keeratrajsinghwork/Stack_based_FC_tMIT/PDB/PDB_Board2.png

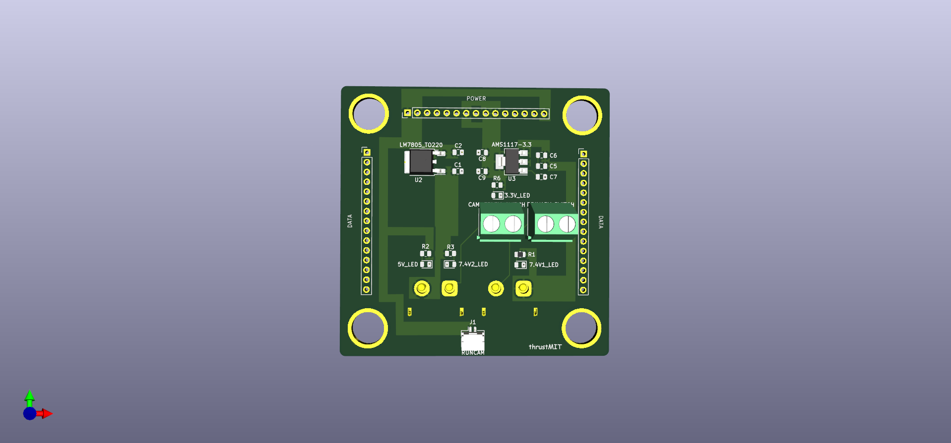
PDB/PDB_Board2.png
