keeratrajsinghwork/Stack_based_FC_tMIT/PDB/PDB_Board.png

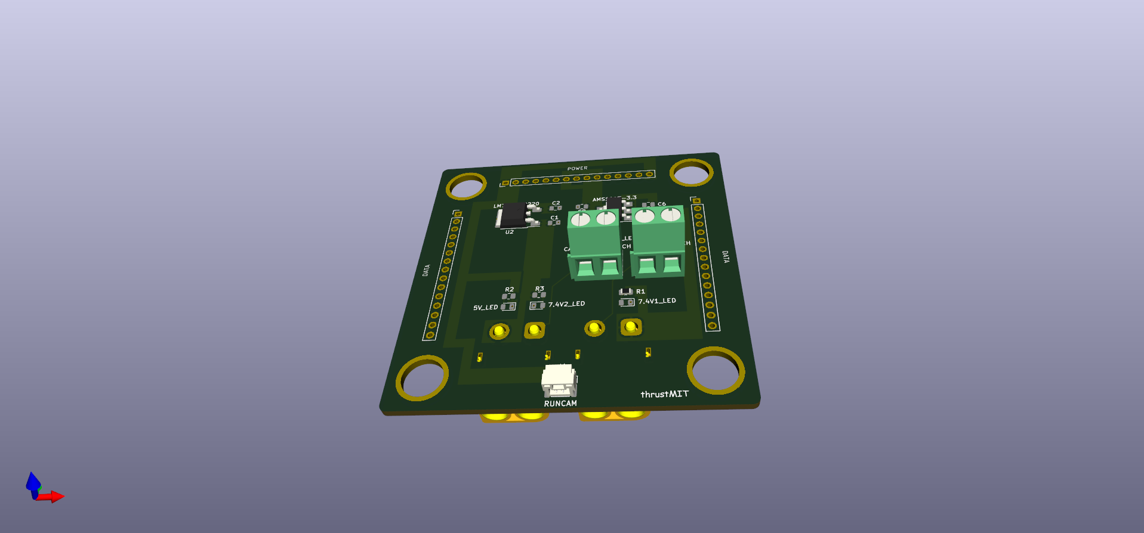
PDB/PDB_Board.png
