keeratrajsinghwork/Stack_based_FC_tMIT/PDB/PDB_Board1.png

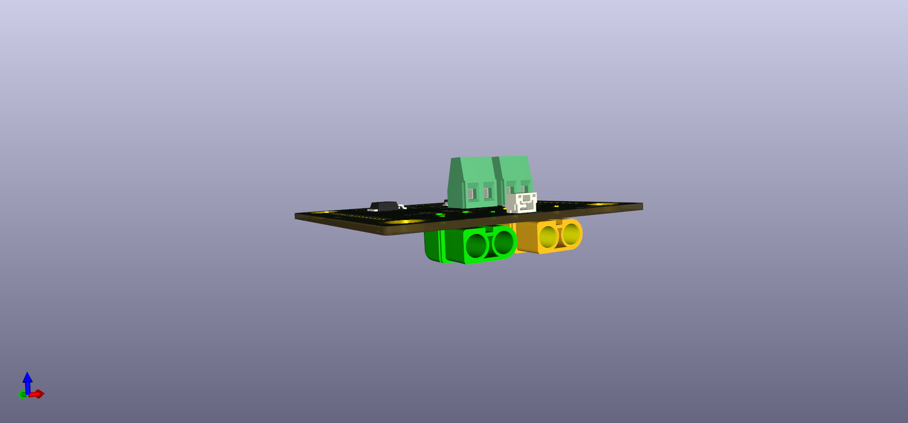
PDB/PDB_Board1.png
