keeratrajsinghwork/Stack_based_FC_tMIT/BOM_Agniastra.xlsx

Sheet: Master_BOM
Sl No. | Component Name | Description | Price(per unit) | Qty | Total Price | Link to Product | Information | Vendor
1 | PZT2222A | Transistor | 33.25 | 10 | 332.5 | PZT2222AT3G - Onsemi - Bipolar (BJT) Single Transistor, NPN, 40 V (element14.com) (https://in.element14.com/on-semiconductor/pzt2222at3g/transistor-bipol-npn-40v-sot-223/dp/2533342?st=pzt2222a) |  | Element14
2 | Capacitor(0805) | 0.1uF | 18 | 7 | 126 | MC0805B104K101CT MULTICOMP PRO MLCC SMD Capacitor 0.1µF, 100 V, 0805 ( Pack of 5) - Robu.in | Indian Online Store | RC Hobby | Robotics (https://robu.in/product/mc0805b104k101ct-multicomp-pro-cap-smd-mlcc-0-1%c2%b5f-100-v-0805-pack-of-5/) | (Pack of 5) | Robu
3 | Capacitor(0805) | 10uF | 12.65 | 2 | 25.3 | TMCP1A106MTRF - Vishay - Surface Mount Tantalum Capacitor, 10 µF, 10 V (element14.com) (https://in.element14.com/vishay/tmcp1a106mtrf/cap-10uf-10v-tant-case-p/dp/3369499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) | (Pack of 5) | Element14
4 | Capacitor(0805) | 0.1uF Tantalum | 21.2 | 2 | 42.4 | TMCP1D104KTRF - Vishay - Surface Mount Tantalum Capacitor, 0.1 µF, 20 V (element14.com) (https://in.element14.com/vishay/tmcp1d104ktrf/cap-0-1-f-20v-10/dp/2491439?st=capacitor%20smd%200.1uf) | (Pack of 5) | Element14
5 | Capacitor(0805) | 4.7uF | 18.9 | 10 | 189 | C0805C475M3PACTU - Kemet - SMD Multilayer Ceramic Capacitor, 4.7 µF, 25 V (element14.com) (https://in.element14.com/kemet/c0805c475m3pactu/cap-4-7-f-25v-20-x5r-0805/dp/2773271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) | minimum order = 10 | Element14
6 | Capacitor(0805) | 10pF | 7.99 | 10 | 79.9 | C0805C100J3GACTU - Kemet - SMD Multilayer Ceramic Capacitor, 10 pF, 25 V (element14.com) (https://in.element14.com/kemet/c0805c100j3gactu/cap-10pf-25v-5-c0g-np0-0805/dp/2905171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) | minimum order = 10 | Element14
7 | Capacitor(0806) | 1uF | 10.98 | 10 | 109.8 | C0805C105K3RECTU - Kemet - SMD Multilayer Ceramic Capacitor, ESD, 1 µF (element14.com) (https://in.element14.com/kemet/c0805c105k3rectu/cap-1uf-25v-mlcc-0805/dp/2991344?st=capacitor%200805%201uF) | minimum order = 10 | Element14
8 | Capacitor(0805) | 0.33uF | 35 | 1 | 35 | Buy 330nF 0805 Surface Mount Multilayer Ceramic Capacitor Online (robu.in) (https://robu.in/product/330nf-0805-surface-mount-multilayer-ceramic-capacitor-pack-of-40/) | (Pack of 40) | Robu
9 | Resistor(0805) | 22 ohm | 0.349 | 30 | 10.47 | MCWR08X22R0FTL - Multicomp Pro - SMD Chip Resistor, 22 ohm, ± 1% (element14.com) (https://in.element14.com/multicomp/mcwr08x22r0ftl/res-22r-1-0-125w-0805-thick-film/dp/2447609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) | minimum order = 10 | Element14
10 | Resistor(0805) | 56 ohm | 1.83 | 30 | 54.9 | WR08X560 JTL - Walsin - SMD Chip Resistor, 56 ohm, ± 5% (element14.com) (https://in.element14.com/walsin/wr08x560-jtl/res-56r-5-0-125w-0805-thick-film/dp/2671059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) | minimum order = 10 | Element14
11 | Resistor(0805) | 100 ohm | 25 | 1 | 25 | Buy 100 Ohm 1/4W 0805 Surface Mount Chip Resistor Online | Robu.in (https://robu.in/product/100-ohm-1-4w-0805-surface-mount-chip-resistor-10-pcs/) | Pack of 10 | Robu
12 | Resistor(0805) | 10k ohm | 29 | 1 | 29 | Buy 10k Ohm 1/4W 0805 Surface Mount Chip Resistor Online | Robu.in (https://robu.in/product/10k-ohm-1-4w-0805-surface-mount-chip-resistor-pack-of-10/) | Pack of 10 | Robu
13 | Resistor(0805) | 2.5k | 11.07 | 10 | 110.7 | MCWF08U2551BTL - Multicomp Pro - SMD Chip Resistor, 2.55 kohm, ± 0.1% (element14.com) (https://in.element14.com/multicomp-pro/mcwf08u2551btl/res-thin-film-2k55-0-1-0-1w-0805/dp/2694274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) | minimum order = 10 | Element14
14 | Resistor(0805) | 200k | 1.21 | 10 | 12.1 | MCSR08X2003FTL - Multicomp Pro - SMD Chip Resistor, 200 kohm, ± 1% (element14.com) (https://in.element14.com/multicomp-pro/mcsr08x2003ftl/res-200k-1-0-125w-0805-thick-film/dp/2074396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) | Pack of 10 | Element14
15 | Resistor(0805) | 383 ohm | 8.31 | 5 | 41.55 | RC0805FR-07383RL - Yageo - RES, 383R, 1% (element14.com) (https://in.element14.com/yageo/rc0805fr-07383rl/res-383r-1-0-125w-thick-film-0805/dp/4061076) |  | Element14
16 | Resistor(0805) | 220 ohm | 4.82 | 10 | 48.2 | ERJUP6J221V - Panasonic - SMD Chip Resistor, 220 ohm, ± 5% (element14.com) (https://in.element14.com/panasonic/erjup6j221v/res-220r-5-0-5w-0805-thick-film/dp/3598292) | minimum order = 10 | Element14
17 | LEDs(0805) | Red | 9.28 | 15 | 139.2 | MP008293 - Multicomp Pro - LED, Red, SMD (element14.com) (https://in.element14.com/multicomp-pro/mp008293/led-red-220mcd-626nm-0805/dp/3796325?st=led%200805) | minimum order = 5 | Element14
18 | LEDs(0805) | Green | 33.15 | 15 | 497.25 | KPT-2012ZGC - Kingbright - LED, Low Power, Green (element14.com) (https://in.element14.com/kingbright/kpt-2012zgc/led-smd-0805-true-green/dp/2217981?st=led%200805%203.3v) | minimum order = 5 | Element14
19 | LEDs(0805) | Blue | 12.77 | 10 | 127.7 | KP-2012QBC-D - Kingbright - LED, Low Power, Blue (element14.com) (https://in.element14.com/kingbright/kp-2012qbc-d/led-smd-0805-blue/dp/2217974?st=led%200805%203.3v) | minimum order = 5 | Element14
20 | LM7805 | Voltage Regulator | 112.05 | 5 | 560.25 | LM78M05CDTX/NOPB - Texas Instruments - Linear Voltage Regulator, Fixed, 7.2V to 35V Input (element14.com) (https://in.element14.com/texas-instruments/lm78m05cdtx-nopb/ldo-fixed-5v-0-5a-to-252-3/dp/3008066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) |  | Element14
21 | AMS1117 | Voltage Regulator | 45 | 1 | 45 | Buy AMS1117-3.3V 1A SOT-223 Voltage Regulator IC (Pack of 5 ICs) Online at Robu.in (https://robu.in/product/ams1117-3-3v-1a-sot-223-voltage-regulator-ic-pack-of-5-ics/) | (Pack of 5) | Robu
22 | Pin Headers | 1x40 | 157 | 2 | 314 | Buy 2.54mm 1x40 Pin Male Single Row Straight Long Header Strip (3 pcs.) (robu.in) (https://robu.in/product/2-54mm-1x40-pin-male-single-row-straight-long-header-strip-pack-of-3/) | (Pack of 3) | Robu
23 | Terminal Block | Terminals | 12 | 5 | 60 | Buy Degson 2 Pin 5.08mm PCB Terminal Block Online at Robu.in (https://robu.in/product/degson-2-pin-5-08mm-pcb-terminal-block/) |  | Robu
24 | microSD card | Connector | 152.99 | 2 | 305.98 | 104031-0811 - Molex - Memory Card Connector, MicroSD, Push-Pull (element14.com) (https://in.element14.com/molex/104031-0811/connector-micro-sd-8pos/dp/2678573?st=104031-0811) |  | Element14
25 | Terminal Block | Terminals 1x03 | 18 | 3 | 54 | 3 Pin Screw Terminal - 2 Pieces pack buy online at Low Price in India - ElectronicsComp.com (https://www.electronicscomp.com/3-pin-screw-terminal?search=3%20pin%205.08mm%20terminal) | (Pack of 2) | Electronics comp
26 | Crystal | Oscillator | 44.17 | 2 | 88.34 | ABM8G-27.000MHZ-18-D2Y-T. - Abracon - CRYSTAL, 27MHZ, 18PF (element14.com) (https://in.element14.com/abracon/abm8g-27-000mhz-18-d2y-t/crystal-27mhz-18pf-3-2-x-2-5mm/dp/1788527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) |  | Element14
27 | D4184 | MOSFET | 52 | 5 | 260 | Buy D4184 Mosfet control Module Replacement Relay Online at Robu.in (https://robu.in/product/d4184-mosfet-control-module-replacement-relay/) |  | Robu
28 | XT60 | Connector(Horizontal) | 199 | 5 | 995 | Probots XT60PW-F Female Connector for LiPo Battery ESC Brushless Motor Buy Online India (https://probots.co.in/xt150-m-male-black-connector-for-lipo-battery-esc-brushless-motor-6.html) |  | Probots
29 | JST | Connector | 38.2 | 4 | 152.8 | SM02B-GHS-TB JST Sales America Inc. | Connectors, Interconnects | DigiKey (https://www.digikey.in/en/products/detail/jst-sales-america-inc./SM02B-GHS-TB/807832?productid=807832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) |  | Digi-Key
30 | Switch PB | Switch | 63.91 | 1 | 63.91 | https://www.mouser.in/ProductDetail/Alps-Alpine/SKRKAEE020?qs=MrosSN5%252BUQW89XjXIp8Ugw%3D%3D&mgh=1
 |  | TOTAL |  |  | 4871.34
 | NOTE: The colours don't mean anything, it is just to sort and look through easily.

Sheet: Sensor
Sl No. | Component Name | Description | Price(per unit) | Qty | Total Price | Link to Product | Information | Vendor
1 | PZT2222A |  | 33.25 | 5 | 166.25 | PZT2222AT3G - Onsemi - Bipolar (BJT) Single Transistor, NPN, 40 V (element14.com) (https://in.element14.com/on-semiconductor/pzt2222at3g/transistor-bipol-npn-40v-sot-223/dp/2533342?st=pzt2222a) |  | Element14
2 | Capacitor(0805) | 0.1uF | 18 | 2 | 36 | MC0805B104K101CT MULTICOMP PRO MLCC SMD Capacitor 0.1µF, 100 V, 0805 ( Pack of 5) - Robu.in | Indian Online Store | RC Hobby | Robotics (https://robu.in/product/mc0805b104k101ct-multicomp-pro-cap-smd-mlcc-0-1%c2%b5f-100-v-0805-pack-of-5/) | (Pack of 5) | Robu
3 | Capacitor(0805) | 10uF | 12.65 | 1 | 12.65 | TMCP1A106MTRF - Vishay - Surface Mount Tantalum Capacitor, 10 µF, 10 V (element14.com) (https://in.element14.com/vishay/tmcp1a106mtrf/cap-10uf-10v-tant-case-p/dp/3369499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) | (Pack of 5) | Element14
4 | Capacitor(0805) | 0.1uF Tantalum | 21.2 | 2 | 42.4 | TMCP1D104KTRF - Vishay - Surface Mount Tantalum Capacitor, 0.1 µF, 20 V (element14.com) (https://in.element14.com/vishay/tmcp1d104ktrf/cap-0-1-f-20v-10/dp/2491439?st=capacitor%20smd%200.1uf) | (Pack of 5) | Element14
5 | Resistor(0805) | 22 ohm | 0.349 | 10 | 3.49 | MCWR08X22R0FTL - Multicomp Pro - SMD Chip Resistor, 22 ohm, ± 1% (element14.com) (https://in.element14.com/multicomp/mcwr08x22r0ftl/res-22r-1-0-125w-0805-thick-film/dp/2447609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) |  | Element14
6 | Resistor(0805) | 56 ohm | 1.83 | 10 | 18.3 | WR08X560 JTL - Walsin - SMD Chip Resistor, 56 ohm, ± 5% (element14.com) (https://in.element14.com/walsin/wr08x560-jtl/res-56r-5-0-125w-0805-thick-film/dp/2671059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) |  | Element14
7 | Resistor(0805) | 100 ohm | 25 | 1 | 25 | Buy 100 Ohm 1/4W 0805 Surface Mount Chip Resistor Online | Robu.in (https://robu.in/product/100-ohm-1-4w-0805-surface-mount-chip-resistor-10-pcs/) | Pack of 10 | Robu
8 | LEDs | Red | 9.28 | 5 | 46.4 | MP008293 - Multicomp Pro - LED, Red, SMD (element14.com) (https://in.element14.com/multicomp-pro/mp008293/led-red-220mcd-626nm-0805/dp/3796325?st=led%200805) | minimum order = 5 | Element14
9 | LEDs | Green | 33.15 | 5 | 165.75 | KPT-2012ZGC - Kingbright - LED, Low Power, Green (element14.com) (https://in.element14.com/kingbright/kpt-2012zgc/led-smd-0805-true-green/dp/2217981?st=led%200805%203.3v) | minimum order = 5 | Element14
10 | LEDs | Blue | 12.77 | 5 | 63.85 | KP-2012QBC-D - Kingbright - LED, Low Power, Blue (element14.com) (https://in.element14.com/kingbright/kp-2012qbc-d/led-smd-0805-blue/dp/2217974?st=led%200805%203.3v) | minimum order = 5 | Element14
 |  | TOTAL |  |  | 580.09

Sheet: MC
Sl No. | Component Name | Description | Price(per unit) | Qty | Total Price | Link to Product | Information | Vendor
1 | PZT2222A |  | 33.25 | 5 | 166.25 | PZT2222AT3G - Onsemi - Bipolar (BJT) Single Transistor, NPN, 40 V (element14.com) (https://in.element14.com/on-semiconductor/pzt2222at3g/transistor-bipol-npn-40v-sot-223/dp/2533342?st=pzt2222a) |  | Element14
2 | Capacitor(0805) | 0.1uF | 18 | 3 | 54 | MC0805B104K101CT MULTICOMP PRO MLCC SMD Capacitor 0.1µF, 100 V, 0805 ( Pack of 5) - Robu.in | Indian Online Store | RC Hobby | Robotics (https://robu.in/product/mc0805b104k101ct-multicomp-pro-cap-smd-mlcc-0-1%c2%b5f-100-v-0805-pack-of-5/) | (Pack of 5) | Robu
3 | Capacitor(0805) | 1uF | 10.98 | 10 | 109.8 | C0805C105K3RECTU - Kemet - SMD Multilayer Ceramic Capacitor, ESD, 1 µF (element14.com) (https://in.element14.com/kemet/c0805c105k3rectu/cap-1uf-25v-mlcc-0805/dp/2991344?st=capacitor%200805%201uF) | minimum order = 10 | Element14
4 | Capacitor(0805) | 4.7uF | 18.9 | 10 | 189 | C0805C475M3PACTU - Kemet - SMD Multilayer Ceramic Capacitor, 4.7 µF, 25 V (element14.com) (https://in.element14.com/kemet/c0805c475m3pactu/cap-4-7-f-25v-20-x5r-0805/dp/2773271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) | minimum order = 10 | Element14
5 | Capacitor(0805) | 10pF | 7.99 | 10 | 79.9 | C0805C100J3GACTU - Kemet - SMD Multilayer Ceramic Capacitor, 10 pF, 25 V (element14.com) (https://in.element14.com/kemet/c0805c100j3gactu/cap-10pf-25v-5-c0g-np0-0805/dp/2905171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) | minimum order = 10 | Element14
6 | Resistor(0805) | 22 ohm | 0.349 | 20 | 6.98 | MCWR08X22R0FTL - Multicomp Pro - SMD Chip Resistor, 22 ohm, ± 1% (element14.com) (https://in.element14.com/multicomp/mcwr08x22r0ftl/res-22r-1-0-125w-0805-thick-film/dp/2447609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) |  | Element14
7 | Resistor(0805) | 56 ohm | 1.83 | 10 | 18.3 | WR08X560 JTL - Walsin - SMD Chip Resistor, 56 ohm, ± 5% (element14.com) (https://in.element14.com/walsin/wr08x560-jtl/res-56r-5-0-125w-0805-thick-film/dp/2671059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) |  | Element14
8 | Resistor(0805) | 10k ohm | 29 | 1 | 29 | Buy 10k Ohm 1/4W 0805 Surface Mount Chip Resistor Online | Robu.in (https://robu.in/product/10k-ohm-1-4w-0805-surface-mount-chip-resistor-pack-of-10/) | Pack of 10 | Robu
9 | Resistor(0805) | 2.5k | 11.07 | 10 | 110.7 | MCWF08U2551BTL - Multicomp Pro - SMD Chip Resistor, 2.55 kohm, ± 0.1% (element14.com) (https://in.element14.com/multicomp-pro/mcwf08u2551btl/res-thin-film-2k55-0-1-0-1w-0805/dp/2694274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) | minimum order = 10 | Element14
10 | Resistor(0805) | 200k | 1.21 | 10 | 12.1 | MCSR08X2003FTL - Multicomp Pro - SMD Chip Resistor, 200 kohm, ± 1% (element14.com) (https://in.element14.com/multicomp-pro/mcsr08x2003ftl/res-200k-1-0-125w-0805-thick-film/dp/2074396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) | Pack of 10 | Element14
11 | Resistor(0805) | 383 ohm | 8.31 | 5 | 41.55 | RC0805FR-07383RL - Yageo - RES, 383R, 1% (element14.com) (https://in.element14.com/yageo/rc0805fr-07383rl/res-383r-1-0-125w-thick-film-0805/dp/4061076) |  | Element14
12 | LEDs | Red | 9.28 | 5 | 46.4 | MP008293 - Multicomp Pro - LED, Red, SMD (element14.com) (https://in.element14.com/multicomp-pro/mp008293/led-red-220mcd-626nm-0805/dp/3796325?st=led%200805) | minimum order = 5 | Element14
13 | LEDs | Green | 33.15 | 5 | 165.75 | KPT-2012ZGC - Kingbright - LED, Low Power, Green (element14.com) (https://in.element14.com/kingbright/kpt-2012zgc/led-smd-0805-true-green/dp/2217981?st=led%200805%203.3v) | (Pack of 5) | Element14
14 | LEDs | Blue | 12.77 | 5 | 63.85 | KP-2012QBC-D - Kingbright - LED, Low Power, Blue (element14.com) (https://in.element14.com/kingbright/kp-2012qbc-d/led-smd-0805-blue/dp/2217974?st=led%200805%203.3v) | minimum order = 5 | Element14
15 | Pin Headers | 1x40 | 157 | 1 | 157 | Buy 2.54mm 1x40 Pin Male Single Row Straight Long Header Strip (3 pcs.) (robu.in) (https://robu.in/product/2-54mm-1x40-pin-male-single-row-straight-long-header-strip-pack-of-3/) | (Pack of 3) | Robu
16 | microSD card | Connector | 152.99 | 2 | 305.98 | 104031-0811 - Molex - Memory Card Connector, MicroSD, Push-Pull (element14.com) (https://in.element14.com/molex/104031-0811/connector-micro-sd-8pos/dp/2678573?st=104031-0811) |  | Element14
17 | Crystal | Oscillator | 44.17 | 2 | 88.34 | ABM8G-27.000MHZ-18-D2Y-T. - Abracon - CRYSTAL, 27MHZ, 18PF (element14.com) (https://in.element14.com/abracon/abm8g-27-000mhz-18-d2y-t/crystal-27mhz-18pf-3-2-x-2-5mm/dp/1788527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) |  | Element14
18 | Switch PB | Switch |  |  | 0
 |  | TOTAL |  |  | 1644.9

Sheet: PDB
Sl No. | Component Name | Description | Price(per unit) | Qty | Total Price | Link to Product | Information | Vendor
1 | LM7805 | Voltage Regulator | 112.05 | 5 | 560.25 | LM78M05CDTX/NOPB - Texas Instruments - Linear Voltage Regulator, Fixed, 7.2V to 35V Input (element14.com) (https://in.element14.com/texas-instruments/lm78m05cdtx-nopb/ldo-fixed-5v-0-5a-to-252-3/dp/3008066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) |  | Element14
2 | AMS1117 | Voltage Regulator | 45 | 1 | 45 | Buy AMS1117-3.3V 1A SOT-223 Voltage Regulator IC (Pack of 5 ICs) Online at Robu.in (https://robu.in/product/ams1117-3-3v-1a-sot-223-voltage-regulator-ic-pack-of-5-ics/) | (Pack of 5) | Robu
3 | Capacitor(0805) | 0.1uF | 18 | 2 | 36 | MC0805B104K101CT MULTICOMP PRO MLCC SMD Capacitor 0.1µF, 100 V, 0805 ( Pack of 5) - Robu.in | Indian Online Store | RC Hobby | Robotics (https://robu.in/product/mc0805b104k101ct-multicomp-pro-cap-smd-mlcc-0-1%c2%b5f-100-v-0805-pack-of-5/) | (Pack of 5) | Robu
4 | Capacitor(0805) | 0.33uF | 35 | 1 | 35 | Buy 330nF 0805 Surface Mount Multilayer Ceramic Capacitor Online (robu.in) (https://robu.in/product/330nf-0805-surface-mount-multilayer-ceramic-capacitor-pack-of-40/) | (Pack of 40) | Robu
5 | Capacitor(0805) | 10uF | 12.65 | 1 | 12.65 | TMCP1A106MTRF - Vishay - Surface Mount Tantalum Capacitor, 10 µF, 10 V (element14.com) (https://in.element14.com/vishay/tmcp1a106mtrf/cap-10uf-10v-tant-case-p/dp/3369499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) | (Pack of 5) | Element14
6 | Resistor(0805) | 220 ohm | 4.82 | 10 | 48.2 | ERJUP6J221V - Panasonic - SMD Chip Resistor, 220 ohm, ± 5% (element14.com) (https://in.element14.com/panasonic/erjup6j221v/res-220r-5-0-5w-0805-thick-film/dp/3598292) | minimum order = 10 | Element14
7 | Resistor(0805) | 56 ohm | 1.83 | 10 | 18.3 | WR08X560 JTL - Walsin - SMD Chip Resistor, 56 ohm, ± 5% (element14.com) (https://in.element14.com/walsin/wr08x560-jtl/res-56r-5-0-125w-0805-thick-film/dp/2671059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) |  | Element14
8 | LEDs | Red | 9.28 | 5 | 46.4 | MP008293 - Multicomp Pro - LED, Red, SMD (element14.com) (https://in.element14.com/multicomp-pro/mp008293/led-red-220mcd-626nm-0805/dp/3796325?st=led%200805) | minimum order = 5 | Element14
9 | LEDs | Green | 33.15 | 5 | 165.75 | KPT-2012ZGC - Kingbright - LED, Low Power, Green (element14.com) (https://in.element14.com/kingbright/kpt-2012zgc/led-smd-0805-true-green/dp/2217981?st=led%200805%203.3v) | minimum order = 5 | Element14
10 | Pin Headers | 1x40 | 157 | 1 | 157 | Buy 2.54mm 1x40 Pin Male Single Row Straight Long Header Strip (3 pcs.) (robu.in) (https://robu.in/product/2-54mm-1x40-pin-male-single-row-straight-long-header-strip-pack-of-3/) | (Pack of 3) | Robu
11 | JST | Connector | 38.2 | 4 | 152.8 | SM02B-GHS-TB JST Sales America Inc. | Connectors, Interconnects | DigiKey (https://www.digikey.in/en/products/detail/jst-sales-america-inc./SM02B-GHS-TB/807832?productid=807832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) |  | Digi-Key
12 | Terminal Block | Terminals | 12 | 5 | 60 | Buy Degson 2 Pin 5.08mm PCB Terminal Block Online at Robu.in (https://robu.in/product/degson-2-pin-5-08mm-pcb-terminal-block/) |  | Robu
13 | XT60 | Connector(Horizontal) | 199 | 5 | 995 | Probots XT60PW-F Female Connector for LiPo Battery ESC Brushless Motor Buy Online India (https://probots.co.in/xt150-m-male-black-connector-for-lipo-battery-esc-brushless-motor-6.html) |  | Probots
 |  | TOTAL |  |  | 2332.35

Sheet: GPIO
Sl No. | Component Name | Description | Price(per unit) | Qty | Total Price | Link to Product | Information | Vendor
1 | Terminal Block | Terminals 1x03 | 18 | 3 | 54 | 3 Pin Screw Terminal - 2 Pieces pack buy online at Low Price in India - ElectronicsComp.com (https://www.electronicscomp.com/3-pin-screw-terminal?search=3%20pin%205.08mm%20terminal) | (Pack of 2) | Electronics comp
2 | D4184 | MOSFET | 52 | 5 | 260 | Buy D4184 Mosfet control Module Replacement Relay Online at Robu.in (https://robu.in/product/d4184-mosfet-control-module-replacement-relay/) |  | Robu
 |  | TOTAL |  |  | 314
