keeratrajsinghwork/Stack_based_FC_tMIT/BOM_Infyuva_ver4.xlsx

Part Number | Quantity | Description | Price | Link
 | 10 | JST connector | 90 | https://robu.in/product/3-pin-jst-xh-2-54mm-pitch-plug-and-socket-with-cable-10-pcs
RCD-24-0.35 | 2 | LED Driver RCD-24-0.35 | 1729.38 | https://in.element14.com/recom-power/rcd-24-0-35/led-driver-dc-dc-cc-0-35a-35v/dp/1793212?ICID=I-RP-STM7REC-2
 | 3 | 10K Potentiometer | 79 | https://robu.in/product/10k-ohm-3pin-15mm-shaft-potentiometer-pack-of-3/
 | 5 | Terminal block | 10 | https://robu.in/product/2-pin-5-08mm-pitch-pluggable-screw-terminal-block-pack-of-3/
 | 1 | Battery | 701.96 | https://quartzcomponents.com/products/12v-2200-mah-rechargeable-lithium-battery-pack-with-warranty-for-gps-cctv-industrial-and-commercial-application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
 |  | Hookup wires | 149 | https://robu.in/product/high-quality-ultra-flexible-24awg-silicone-wire-5m-red/
C0603C103K2RECTU | 10 | Capacitors 10n | 43.8 | https://in.element14.com/multicomp/mcsh31b103k500ct/cap-0-01-f-50v-10-x7r-1206/dp/1856592
SRR1208-121YL | 2 | Inductor 120uH | 146.52 | https://in.element14.com/bourns/srr1208-121yl/inductor-120uh-15-1-4a-smd/dp/2333691
MCWF08R2611BTL | 10 | Resistors 2.61k | 128.7 | https://in.element14.com/panasonic/erj8enf2611v/res-2k61-1-0-25w-1206-thick-film/dp/2307566
ERJP06F4641V | 10 | Resistors 4.64k | 80.7 | https://in.element14.com/panasonic/erjp08f4641v/res-4k64-1-0-66w-1206-thick-film/dp/2327245
 |  | Total | 3159.06
