keeratrajsinghwork/Stack_based_FC_tMIT/FC'24.xlsx

Sheet: Main
S.no | Name | Description | Quantity | Price/piece | Cost | Vendor | Link | Stock | Status | Voltage Rating(V) | Current Consumption(A) | Units | Operation Duration (h) | FOS
1 | STM32411CEU SMT | MC | 1 | 675 | 675 | Digikey | https://www.digikey.in/en/products/detail/stmicroelectronics/STM32F411CEU6/4935720 | 13000 |  | 3.3 | 100 | μ
2 | LPS22HB THT | Baro low G | 1 | 578 | 578 | Digikey | https://www.digikey.in/en/products/detail/adafruit-industries-llc/4633/12396897?productid=12396897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 | 31 |  |  |  | μ | 5 | 1.2
3 | LPS22HB SMT |  | 1 | 370 | 370 | Element14 | https://in.element14.com/stmicroelectronics/lps22hbtr/pressure-sensor-26-126kpa-40to85deg/dp/2532382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 | 93000 |  | 3.3 | 12 | μ
4 | MS6507 THT | Baro high G | 1 | 2028 | 2028 | Tanotis | https://www.tanotis.com/products/mikroelektronika-mikroe-3030-add-on-board-altitude-2-click-ms5607-barometric-pressure-sensor-i2c-spi-mikrobus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 | . |  |  |  | μ | Battery | Capacity (mAh) | Voltage (V) | Max Discharge (C) | Dimensions(mm) | Weight (g) | Cost | Vendor | Link | Stock | Status
5 | MS6507 SMT |  | 1 | 903 | 903 | Digikey | https://www.digikey.in/en/products/detail/te-connectivity-measurement-specialties/MS560702BA03-50/4700931 | 61000 |  | 3.3 | 12.5 | μ | SRAD | 1000 | 7.4 | 5 | 70 x 40 x 25 | 130 | 589 | Robu | https://robu.in/product/orange-isr-18650-li-ion-1500mah-7-4v-2s1p-protected-battery-pack-15c/ | OnDemand
6 | LSM6DS032X THT | IMU low G | 1 | 2301 | 2301 | Tanotis | https://www.tanotis.com/products/stmicroelectronics-steval-mki221v1-plug-in-module-lsm6dso32x-mems-motherboard-new | . |  |  |  | μ | COTS | 600 | 7.4 | 5 | 70 x 40 x 24 | 130 | 589 | Robu | https://robu.in/product/orange-isr-18650-li-ion-1500mah-7-4v-2s1p-protected-battery-pack-15c/?gad_source=1 | OnDemand
7 | LSM6DS032X SMT |  | 1 | 613 | 613 | Element14 | https://in.element14.com/stmicroelectronics/lsm6dso32xtr/mems-module-1-71v-to-3-6v-lga/dp/3758574?st=lsm6dso | 10500 |  | 3.3 | 170 | μ | Pyro | 2000 | 7.4 | 10 | 80 x 30 x 50 | 141 | 1159 | Robu | https://robu.in/product/panasonic-ncr18650ga-7-4v-3300mah-3c-2s1p-li-ion-battery-pack/ | OnDemand
8 | ADXL375 THT | IMU high G | 1 | 2082 | 2082 | Adafruit | https://www.adafruit.com/product/5374 | 27 |  |  |  | μ | Camera + Telem | 6000 | 7.4 | 3 | 73 x 44 x 44 | 150 | 1539 | Robu | https://robu.in/product/orange-18650-li-ion-6000mah-7-4v-2s1p-protected-battery-pack-3c/ | OnDemand
9 | ADXL375 SMT |  | 1 | 1270 | 1270 | Element14 | https://in.element14.com/analog-devices/adxl375bccz-rl7/mems-accelerometer-digital-x-y/dp/4030128?st=adxl37 | 2100 |  | 3.3 | 35 | μ
10 | Mikroe GNSS 8 Click | GPS | 1 | 4574 | 4574 | Digikey | https://www.digikey.in/en/products/detail/mikroelektronika/MIKROE-4673/16182517 | 6 |  | 3.3 | 36 | μ | Component | Weight (g) |  | Key
11 | RYLR998 | Telem 1 | 2 | 3398 | x | Amazon | https://www.amazon.in/RYLR998-Interface-Antenna-Transceiver-Module/dp/B099RM1XMG | . |  | 3.3 | 140 | m | SRAD Stack | 1350 |  |  | Not Ordered
12 | LAMBDA-9S | Telem 2 | 2 | 1929 | x | Element14 | https://in.element14.com/rf-solutions/lambda-9s/rf-transceiver-module-300kbps/dp/2841160 | 1900 |  | 3.3 | 125 | m | COTS | 50 |  |  | PO Placed
13 | Runcam Thumb | Camera | 2 | 5499 | 10998 | Robu | https://robu.in/product/runcam-thumb-1080p-mini-action-camera/ | . |  | 5 | 280 | m | Cameras | 20 |  |  | Ordered
14 |  | TX antenna |  |  | 0 |  |  |  |  |  |  |  | Batteries | 551 |  |  | Received
15 |  | RX antenna |  |  | 0 |  |  |  |  |  |  |  | Rods | 624 |  |  | Refunded
16 | RFD900ux US | Telem XX | 1 | 25511 | 25511 | RFDesign | https://store.rfdesign.com.au/rfd900x-us-modem-bundle-fcc-approved-hs-8517-62-00-90/ | . |  | 5 | 1 |  | Mounts | 300
17 | Pin Headers Tall | Stack connectors | 10 | 89 | 890 | ElectronicsComp | https://www.electronicscomp.com/1x40-pin-2.54mm-pitch-straight-long-female-berg-strip-connector?gad_source=1 | 232
18 |  |  |  |  | 0
19 |  |  |  |  | 0
20 |  |  |  |  | 0
21 |  |  |  |  | 0
22 |  |  |  |  | 0
23 |  |  |  |  | 0 |  |  |  |  |  |  |  | Total | 2895
24 |  |  |  |  | 0
25 |  |  |  |  | 0
26 |  |  |  |  | 0
27 |  |  |  |  | 0
28 |  |  |  |  | 0
29 |  |  |  |  | 0
30 |  |  |  |  | 0
 |  |  |  | Total | 56080

Sheet: Indian
S.no | Name | Description | Quantity | Price/piece | Cost | Vendor | Link | Stock | Status
1 | STM32411CEU SMT | MC | 1 | 617 | 617 | Arrow | https://www.arrow.com/en/products/stm32f411ceu6/stmicroelectronics?gad_source=1&gclsrc=aw.ds | 964
2 | LPS22HB THT | Baro low G | 1 | 576 | 576 | Mouser | https://www.mouser.in/ProductDetail/Adafruit/4633?qs=W%2FMpXkg%252BdQ4ebNdNVsYA5Q%3D%3D | 74
3 | LPS22HB SMT |  | 1 | 294 | 294 | Arrow | https://www.arrow.com/en/products/lps22hbtr/stmicroelectronics | 4200
4 | MS6507 THT | Baro high G | 1 | 2028 | 2028 | Tanotis | https://www.tanotis.com/products/mikroelektronika-mikroe-3030-add-on-board-altitude-2-click-ms5607-barometric-pressure-sensor-i2c-spi-mikrobus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 | .
5 | MS6507 SMT |  | 1 | 831 | 831 | Mouser | https://www.mouser.in/ProductDetail/Measurement-Specialties/MS560702BA03-50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 | 54400
6 | LSM6DS032X THT | IMU low G | 1 | 2301 | 2301 | Tanotis | https://www.tanotis.com/products/stmicroelectronics-steval-mki221v1-plug-in-module-lsm6dso32x-mems-motherboard-new | .
7 | LSM6DS032X SMT |  | 1 | 613 | 613 | Element14 | https://in.element14.com/stmicroelectronics/lsm6dso32xtr/mems-module-1-71v-to-3-6v-lga/dp/3758574?st=lsm6dso | 10500
8 | ADXL375 THT | IMU high G | 1 | 3286 | 3286 | Element14 | https://in.element14.com/analog-devices/eval-adxl375z/eval-board-3-axis-mems-accelerometer/dp/4033199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 | 2
9 | ADXL375 SMT |  | 1 | 1270 | 1270 | Element14 | https://in.element14.com/analog-devices/adxl375bccz-rl7/mems-accelerometer-digital-x-y/dp/4030128?st=adxl37 | 2100
10 | Mikroe GNSS 8 Click | GPS | 1 |  | 1 |  |  | .
11 | RYLR998 | Telem 1 | 2 |  | 2 |  |  | .
12 | LAMBDA-9S | Telem 2 | 2 |  | 2 |  |  | .
13 | Runcam Thumb | Camera | 2 |  | 2 |  |  | .
14 |  | TX antenna |  |  | 0 |  |  | .
15 |  | RX antenna |  |  | 0 |  |  | .
16 | RFD900ux US | Telem XX | 1 |  | 1 |  |  | .
17 | Pin Headers Tall | Stack connectors | 10 |  | 10 |  |  | .
18 |  |  |  |  | 0 |  |  | .
19 |  |  |  |  | 0 |  |  | .
20 |  |  |  |  | 0 |  |  | ..
21 |  |  |  |  | 0 |  |  | .
22 |  |  |  |  | 0
23 |  |  |  |  | 0
24 |  |  |  |  | 0 |  |  | .
25 |  |  |  |  | 0 |  |  | .
26 |  |  |  |  | 0
27 |  |  |  |  | 0 |  |  | .
28 |  |  |  |  | 0
29 |  |  |  |  | 0 |  |  | .
30 |  |  |  |  | 0 |  |  | .
 |  |  |  | Total | 11834

Sheet: Sheet2
S.no | Name | Description | Quantity | Price/piece | Cost | Vendor | Link | Stock | Status
1 | STM32411CEU SMT | MC | 1 | 675 | 675 | Digikey | https://www.digikey.in/en/products/detail/stmicroelectronics/STM32F411CEU6/4935720 | 13000
2 | LPS22HB THT | Baro low G | 1 | 578 | 578 | Digikey | https://www.digikey.in/en/products/detail/adafruit-industries-llc/4633/12396897?productid=12396897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 | 31
3 | LPS22HB SMT |  | 1 | 370 | 370 | Element14 | https://in.element14.com/stmicroelectronics/lps22hbtr/pressure-sensor-26-126kpa-40to85deg/dp/2532382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 | 93000
4 | MS6507 THT | Baro high G | 1 | 2028 | 2028 | Tanotis | https://www.tanotis.com/products/mikroelektronika-mikroe-3030-add-on-board-altitude-2-click-ms5607-barometric-pressure-sensor-i2c-spi-mikrobus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 | .
5 | MS6507 SMT |  | 1 | 903 | 903 | Digikey | https://www.digikey.in/en/products/detail/te-connectivity-measurement-specialties/MS560702BA03-50/4700931 | 61000
6 | LSM6DS032X THT | IMU low G | 1 | 2301 | 2301 | Tanotis | https://www.tanotis.com/products/stmicroelectronics-steval-mki221v1-plug-in-module-lsm6dso32x-mems-motherboard-new | .
7 | LSM6DS032X SMT |  | 1 | 613 | 613 | Element14 | https://in.element14.com/stmicroelectronics/lsm6dso32xtr/mems-module-1-71v-to-3-6v-lga/dp/3758574?st=lsm6dso | 10500
8 | ADXL375 THT | IMU high G | 1 | 2082 | 2082 | Adafruit | https://www.adafruit.com/product/5374 | 27
9 | ADXL375 SMT |  | 1 | 1270 | 1270 | Element14 | https://in.element14.com/analog-devices/adxl375bccz-rl7/mems-accelerometer-digital-x-y/dp/4030128?st=adxl37 | 2100
10 | Mikroe GNSS 8 Click | GPS | 1 | 4574 | 4574 | Digikey | https://www.digikey.in/en/products/detail/mikroelektronika/MIKROE-4673/16182517 | 6
11 | RYLR998 | Telem 1 | 2 | 3398 | x | Amazon | https://www.amazon.in/RYLR998-Interface-Antenna-Transceiver-Module/dp/B099RM1XMG | .
12 | LAMBDA-9S | Telem 2 | 2 | 1929 | x | Element14 | https://in.element14.com/rf-solutions/lambda-9s/rf-transceiver-module-300kbps/dp/2841160 | 1900
13 | Runcam Thumb | Camera | 2 | 5499 | 10998 | Robu | https://robu.in/product/runcam-thumb-1080p-mini-action-camera/ | .
14 |  | TX antenna |  |  | 0
15 |  | RX antenna |  |  | 0
16 | RFD900ux US | Telem XX | 1 | 25511 | 25511 | RFDesign | https://store.rfdesign.com.au/rfd900x-us-modem-bundle-fcc-approved-hs-8517-62-00-90/ | .
17 | Pin Headers Tall | Stack connectors | 10 | 89 | 890 | ElectronicsComp | https://www.electronicscomp.com/1x40-pin-2.54mm-pitch-straight-long-female-berg-strip-connector?gad_source=1 | 232
18 |  |  |  |  | 0
19 |  |  |  |  | 0
20 |  |  |  |  | 0
21 |  |  |  |  | 0
22 |  |  |  |  | 0
23 |  |  |  |  | 0
24 |  |  |  |  | 0
25 |  |  |  |  | 0
26 |  |  |  |  | 0
27 |  |  |  |  | 0
28 |  |  |  |  | 0
29 |  |  |  |  | 0
30 |  |  |  |  | 0
 |  |  |  | Total | 52793
