keeratrajsinghwork/Stack_based_FC_tMIT/MC_stack/MC_stack.step

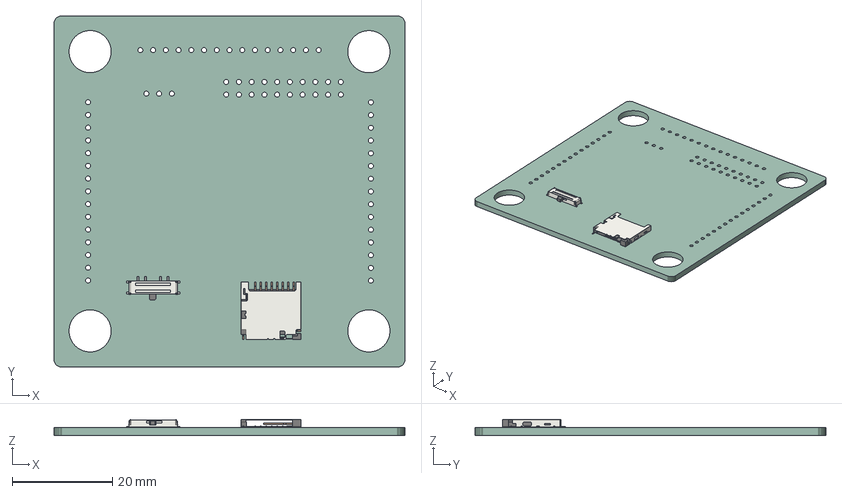
[picture p4: CAD file, 2024-08-11]
MC_stack/MC_stack.step
70.0 x 70.0 x 3.20 mm
MC_stack PCB
