keeratrajsinghwork/Stack_based_FC_tMIT/PDB/PDB_Board.step

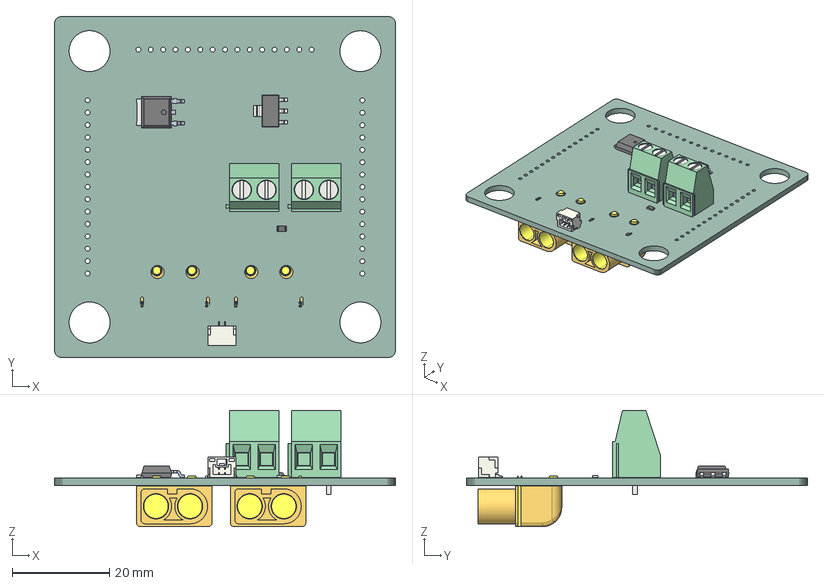
[picture p5: CAD file, 2024-08-11]
PDB/PDB_Board.step
70.0 x 70.0 x 23.9 mm
PDB_Board PCB
