keeratrajsinghwork/Stack_based_FC_tMIT/Sensor_stack/Sensor_Stack/Sensor_Stack.step

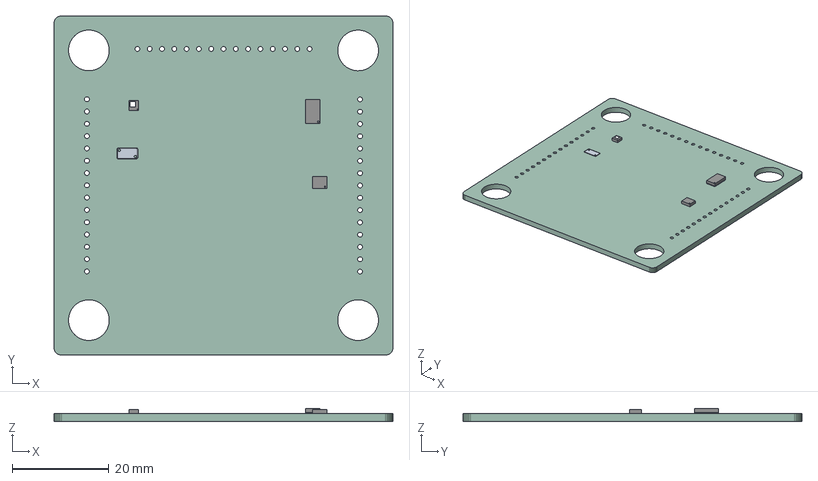
[picture p6: CAD file, 2024-08-11]
Sensor_stack/Sensor_Stack/Sensor_Stack.step
70.0 x 70.0 x 2.63 mm
Sensor_Stack PCB
