keeratrajsinghwork/Stack_based_FC_tMIT/Telemetry_stack/Telemetry_Stack/Telemetry_Stack.step

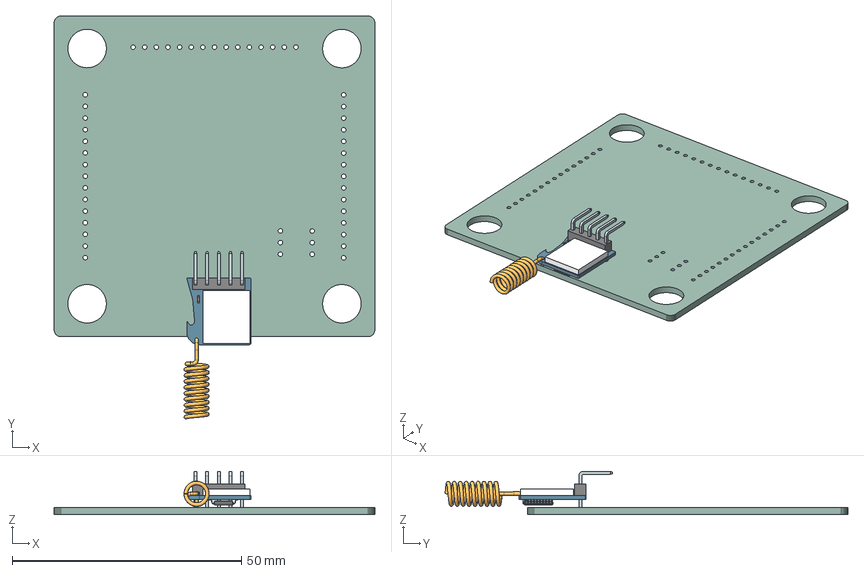
[picture p7: CAD file, 2024-08-11]
Telemetry_stack/Telemetry_Stack/Telemetry_Stack.step
70.0 x 88.0 x 9.42 mm
_autosave-Telemetry_Stack PCB
