keeratrajsinghwork/Stack_based_FC_tMIT/Blank diagram (1).pdf

Wi | r i | ng Di | agr am f or FC' 24

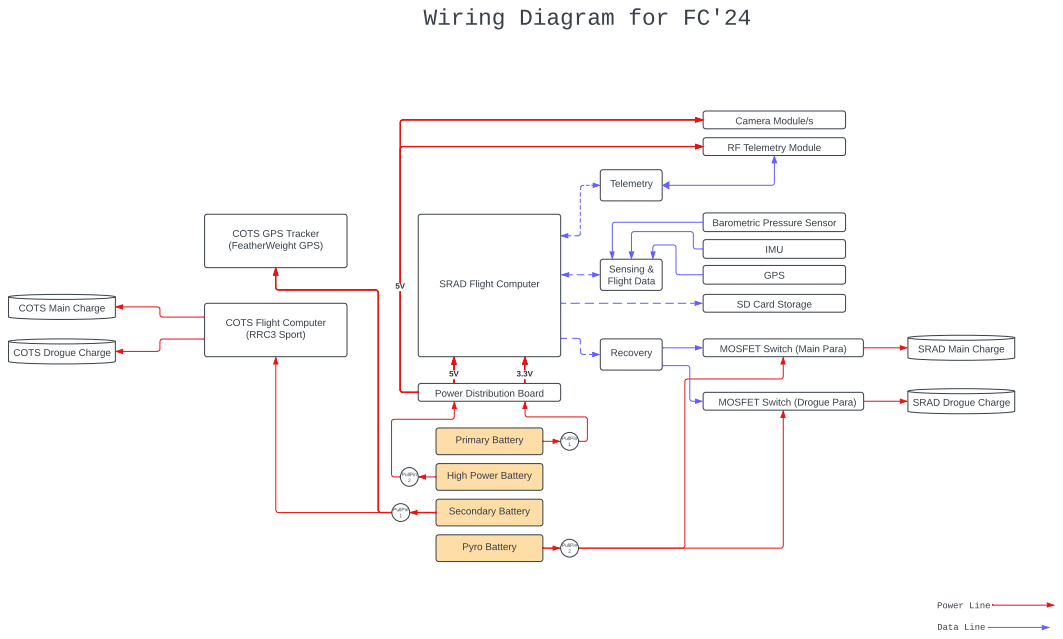
[picture p8: page 1]
Primary Battery; Secondary Battery; Pyro Battery; IMU; GPS; Sensing & Flight Data; Recovery; MOSFET Switch (Main Para); Camera Module/s; Telemetry; PullPin 1; PullPin 2

RF Telemetry Module

Barometric Pressure Sensor

COTS GPS Tracker
(FeatherWeight GPS)

SRAD Flight Computer

SD Card Storage

COTS Main Charge

COTS Flight Computer
(RRC3 Sport)

COTS Drogue Charge

SRAD Main Charge

Power Distribution Board

MOSFET Switch (Drogue Para)

SRAD Drogue Charge

High Power Battery

Power Li ne

Dat a Li ne
