keeratrajsinghwork/Stack_based_FC_tMIT/GPIO_stack/gpio.pdf

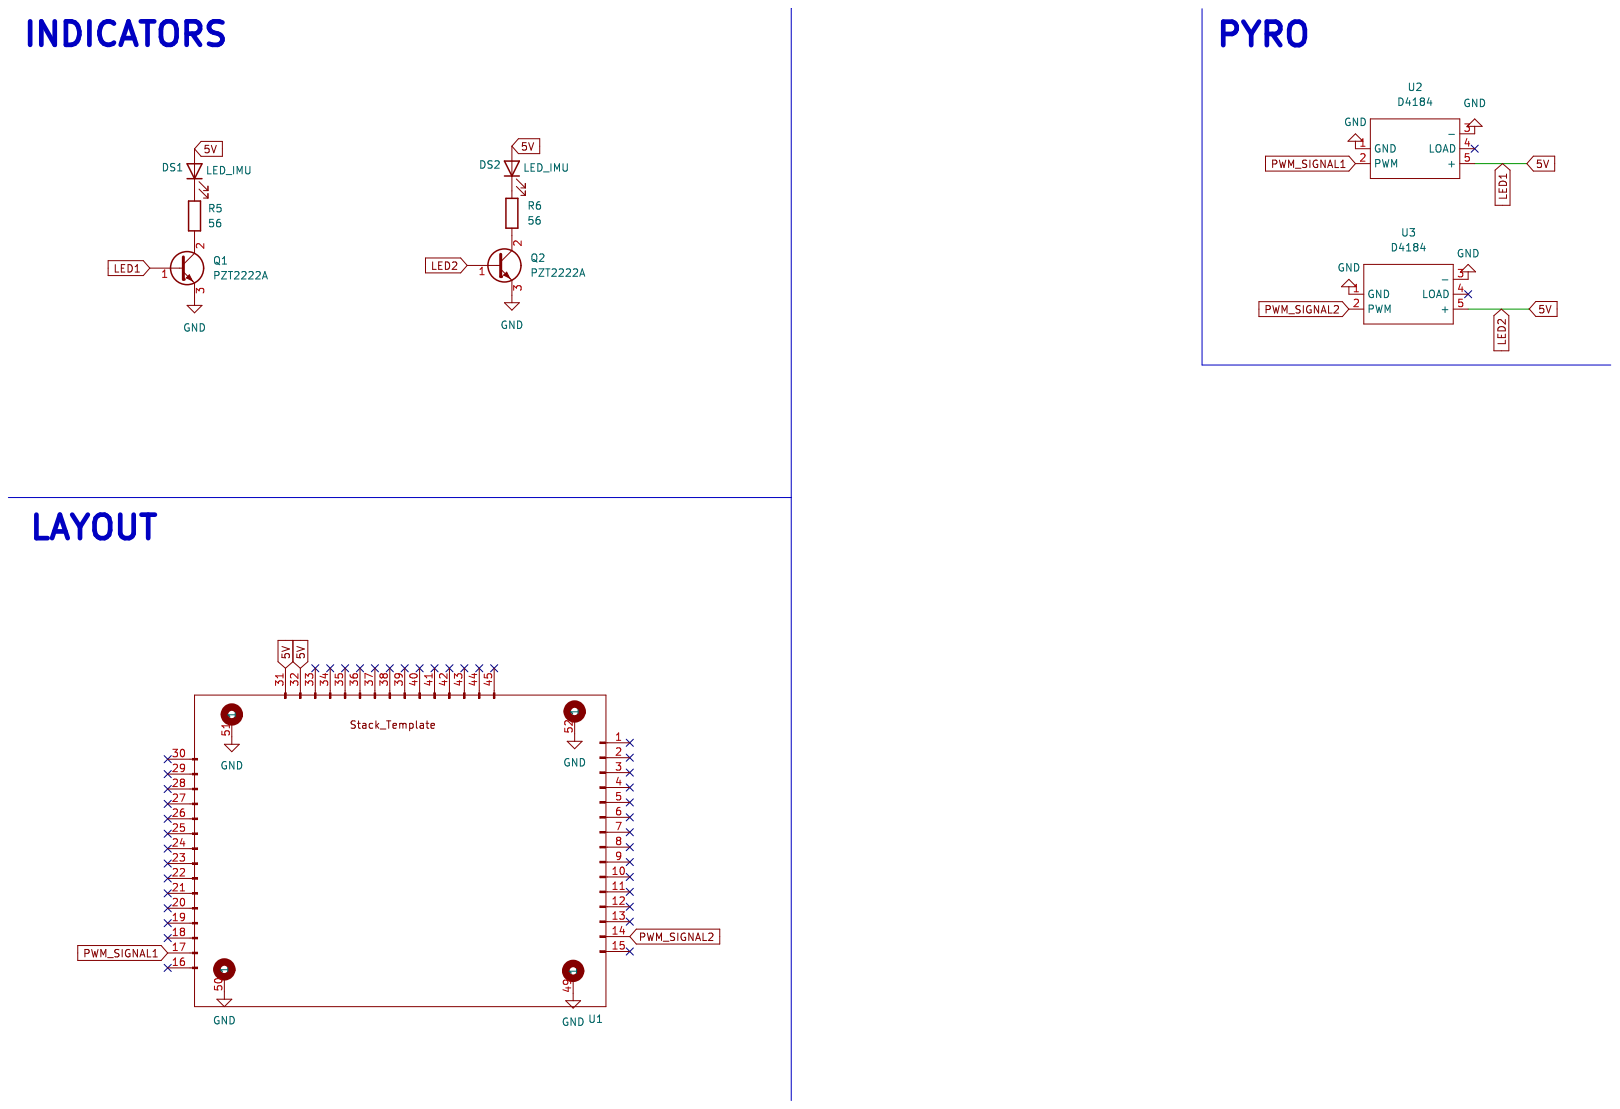
[picture p9: page 1]
