keeratrajsinghwork/Stack_based_FC_tMIT/GPS_Stack/GPS_sch.pdf

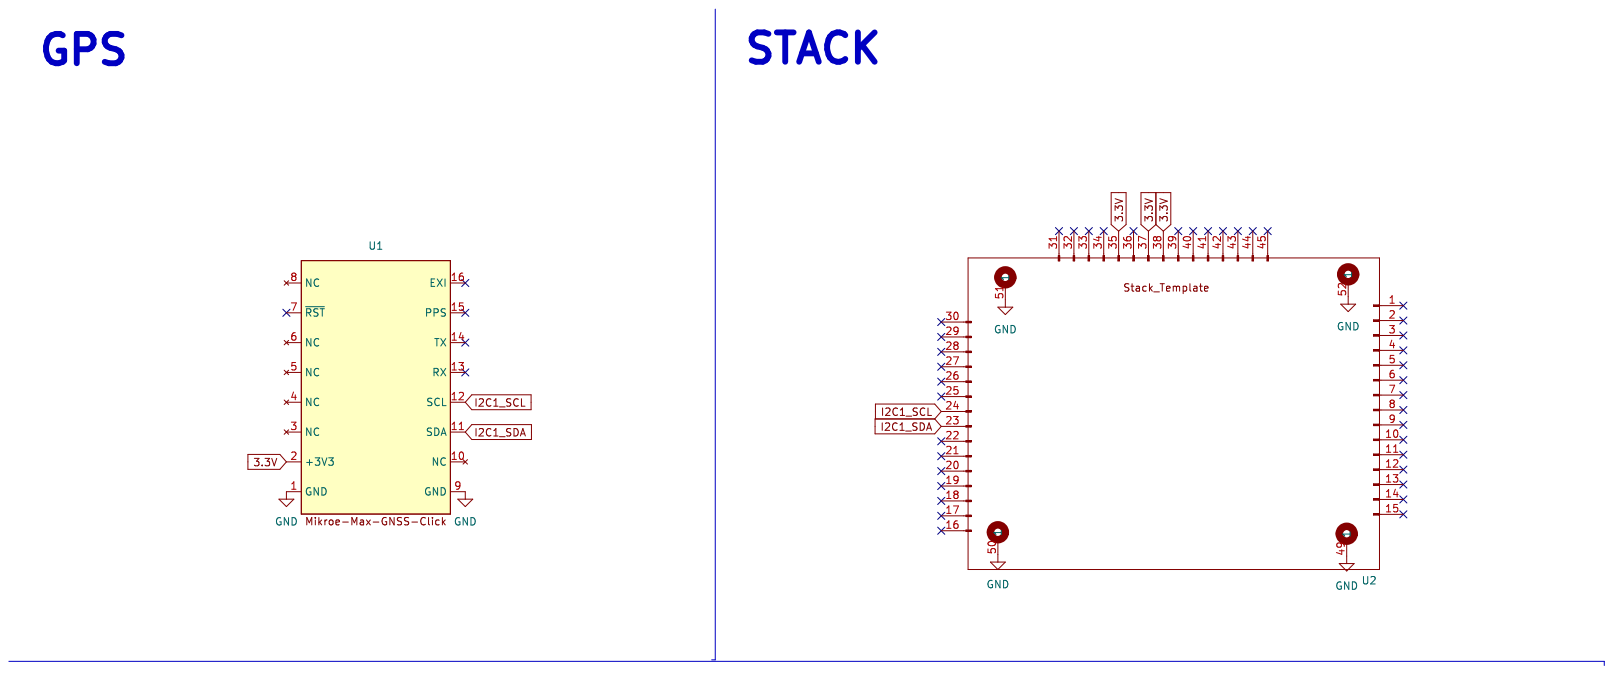
[picture p10: page 1]
