keeratrajsinghwork/Stack_based_FC_tMIT/MC_stack/mc.pdf

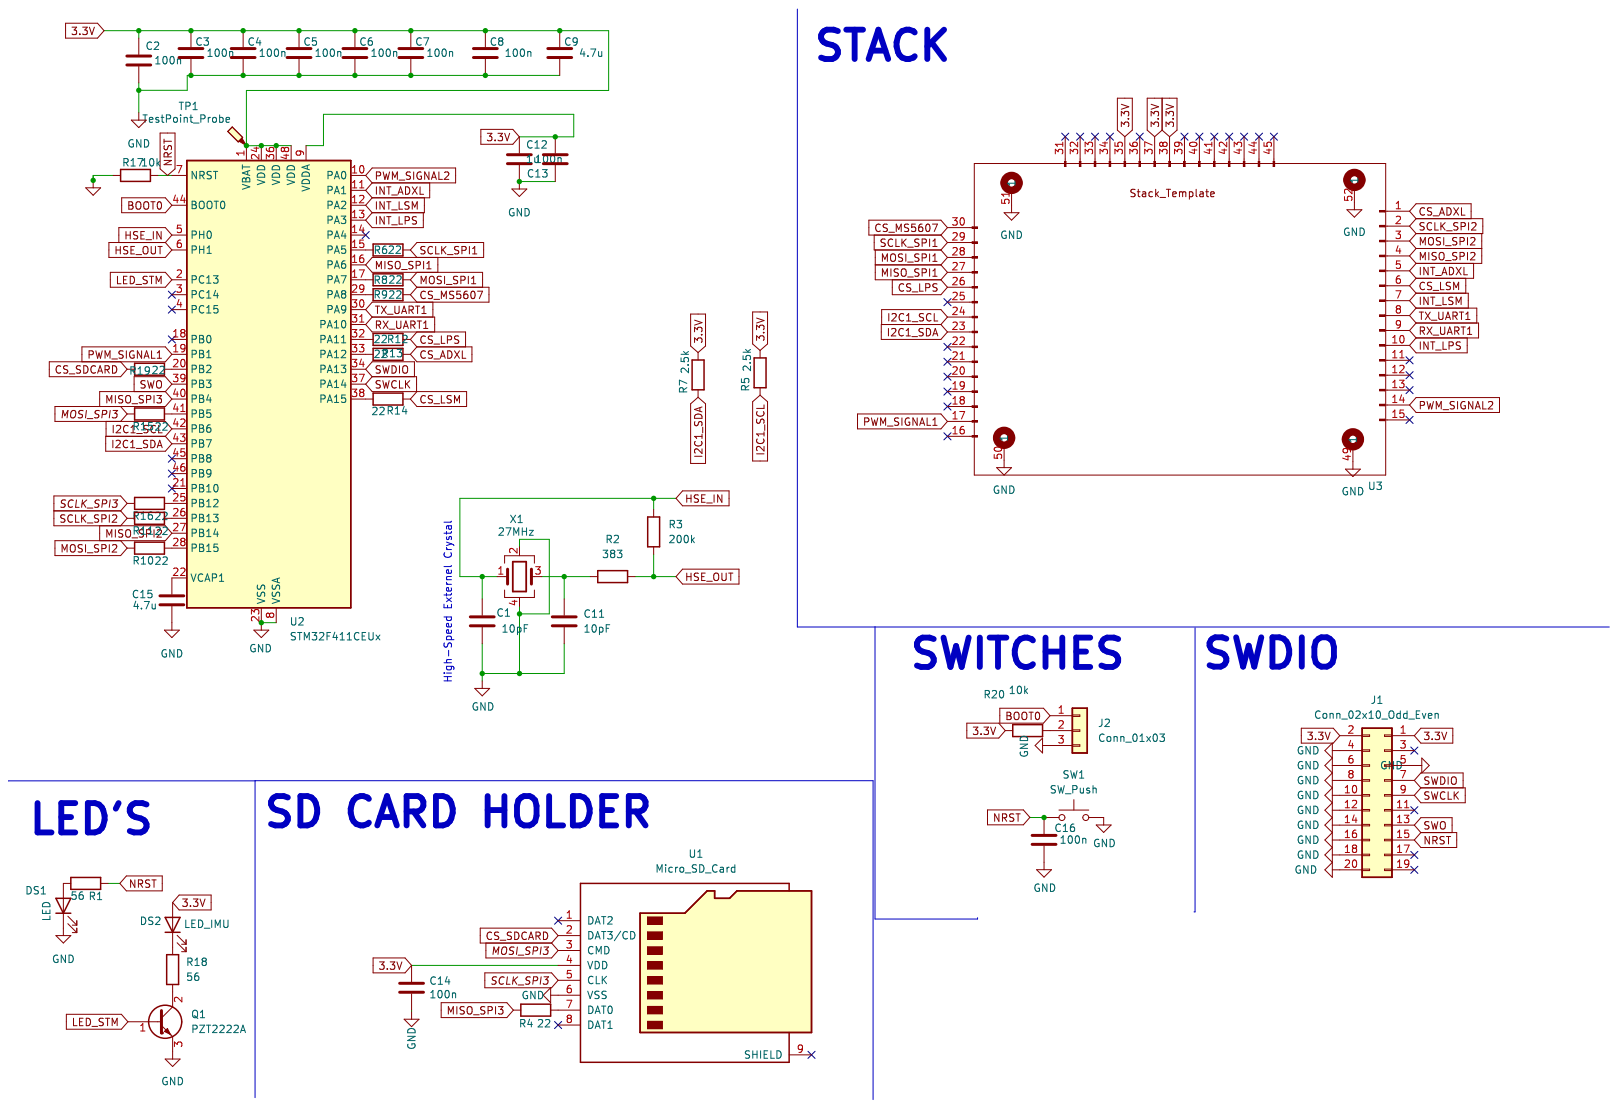
[picture p11: page 1]
