keeratrajsinghwork/Stack_based_FC_tMIT/MC_stack/MC_sch.pdf

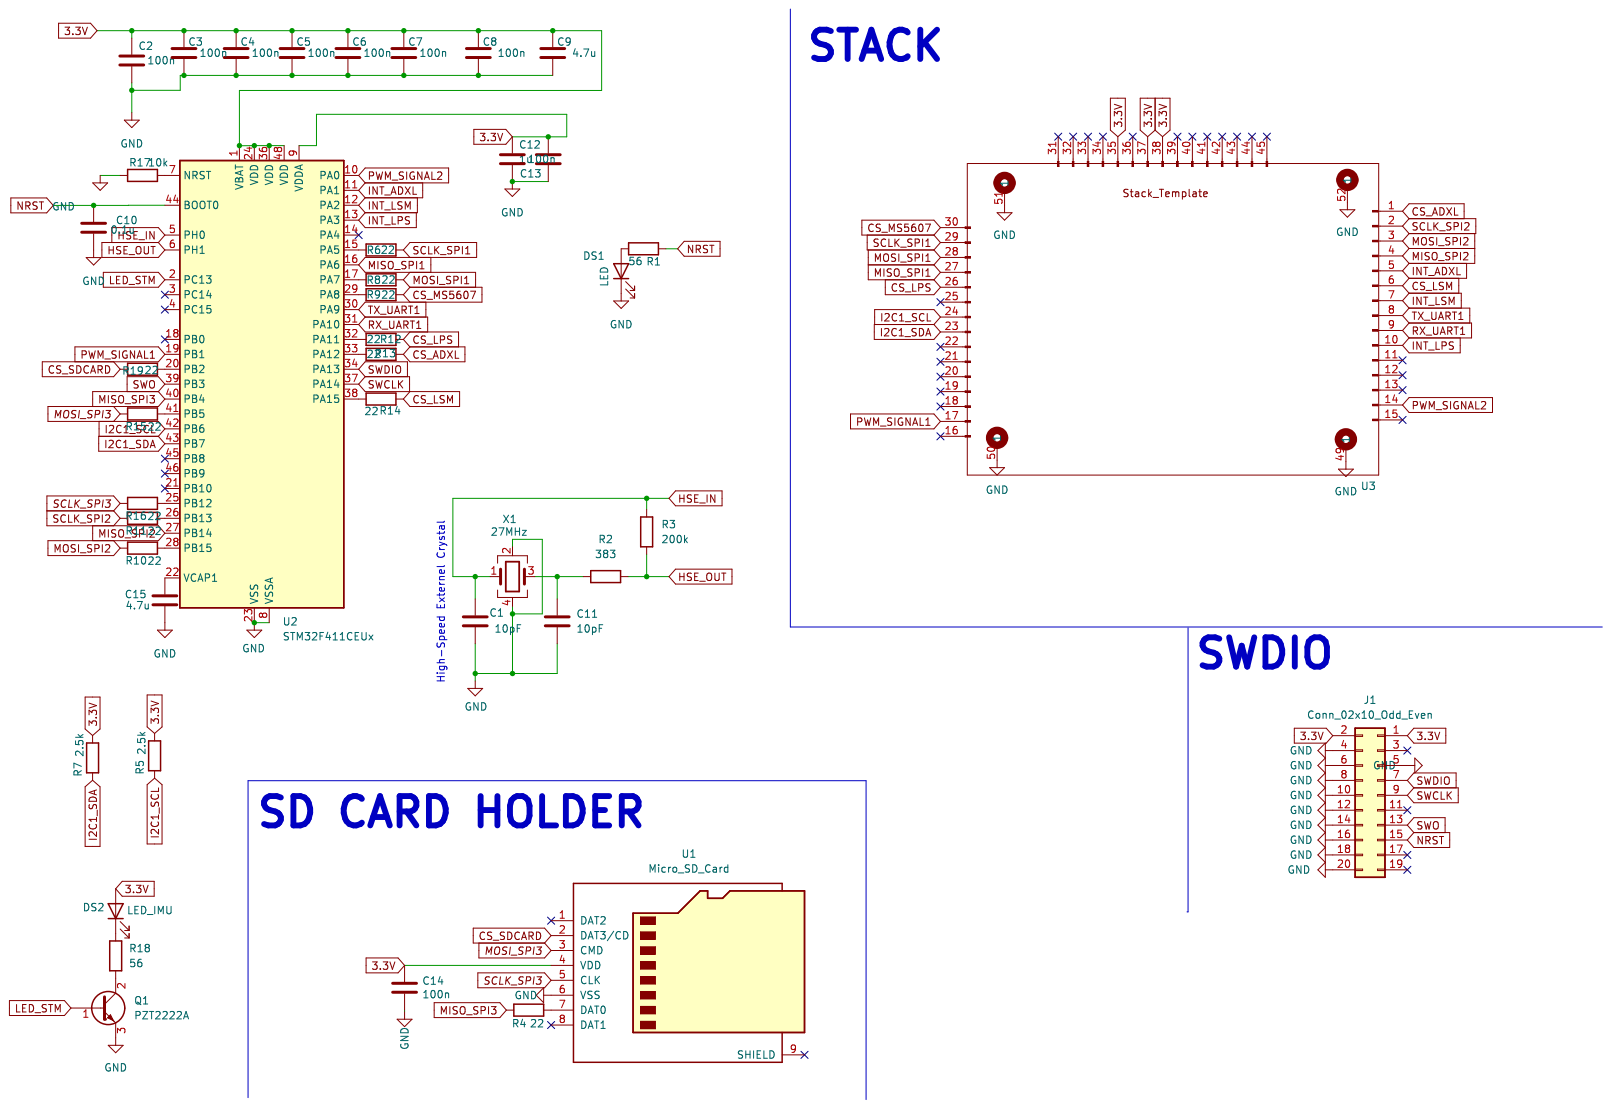
[picture p12: page 1]
