keeratrajsinghwork/Stack_based_FC_tMIT/PDB/pdb.pdf

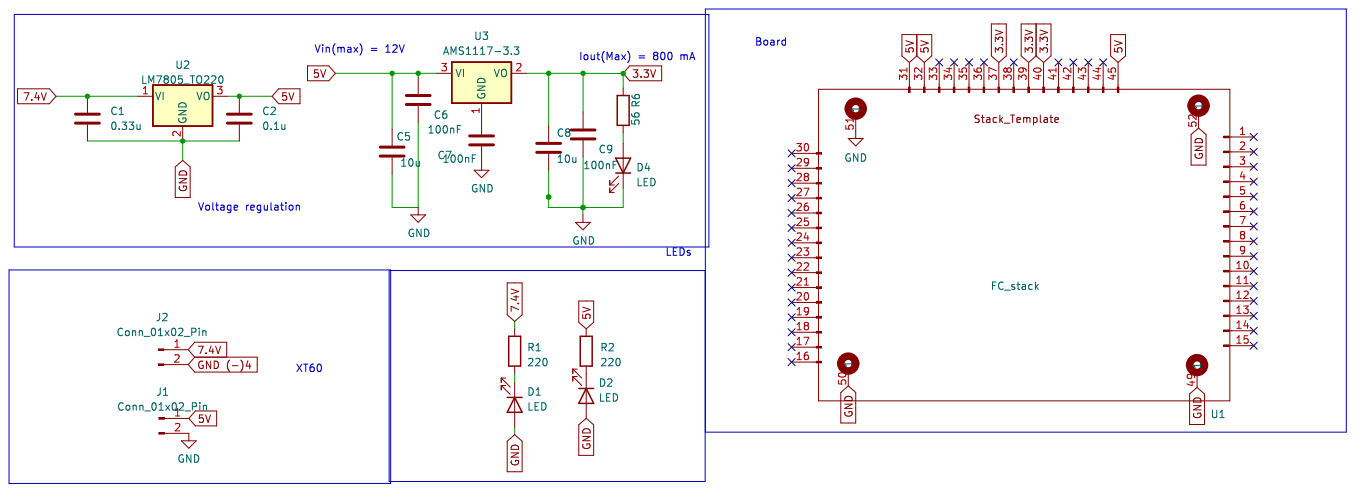
[picture p13: page 1]
