keeratrajsinghwork/Stack_based_FC_tMIT/Sensor_stack/Sensor_Stack/sensor.pdf

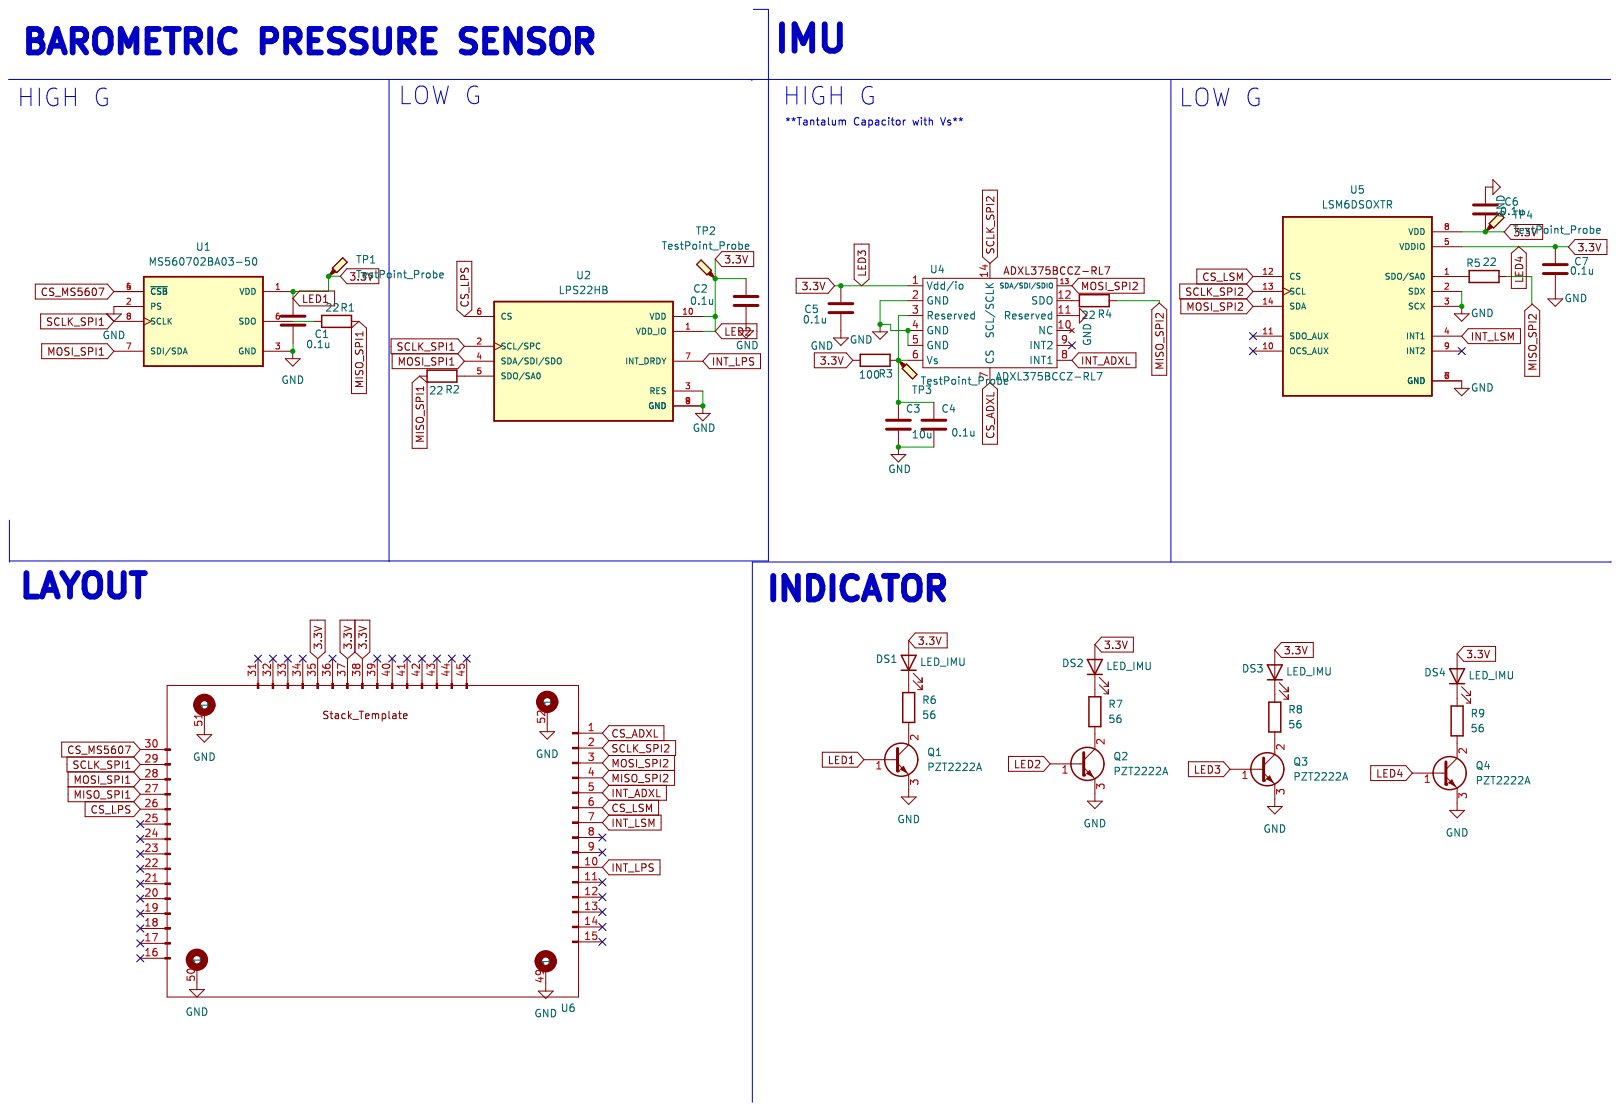
[picture p14: page 1]
