keeratrajsinghwork/Stack_based_FC_tMIT/Telemetry_stack/Telemetry_Stack/Telemetry_Stack.kicad_pcb

## KiCad design Telemetry_stack/Telemetry_Stack/Telemetry_Stack.kicad_pcb (2024-08-11)

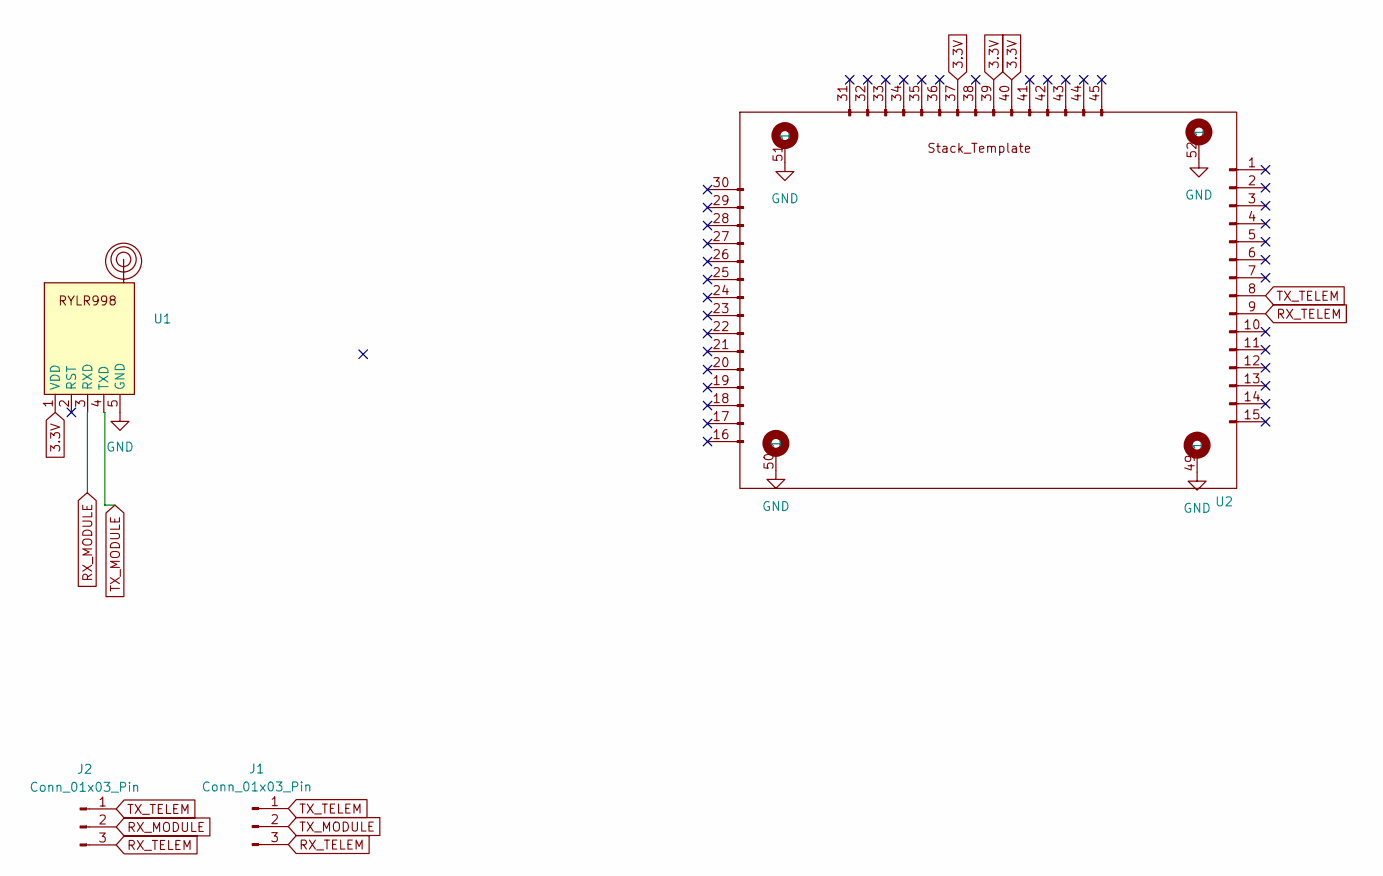
[picture p15: schematic Telemetry_Stack.kicad_sch]

Parts:
J1, J2: Conn_01x03_Pin; PinHeader_1x03_P2.54mm_Vertical
U1: RYLR998
U2: FC_Stack_template

Connections:
3.3V: U1.1 (VDD), U2.37, U2.39, U2.40
GND: U1.5 (GND), U2.49 (1), U2.50 (1), U2.51 (1), U2.52 (1)
RX_MODULE: J2.2, U1.3 (RXD)
RX_TELEM: J1.3, J2.3, U2.9
TX_MODULE: J1.2, U1.4 (TXD)
TX_TELEM: J1.1, J2.1, U2.8

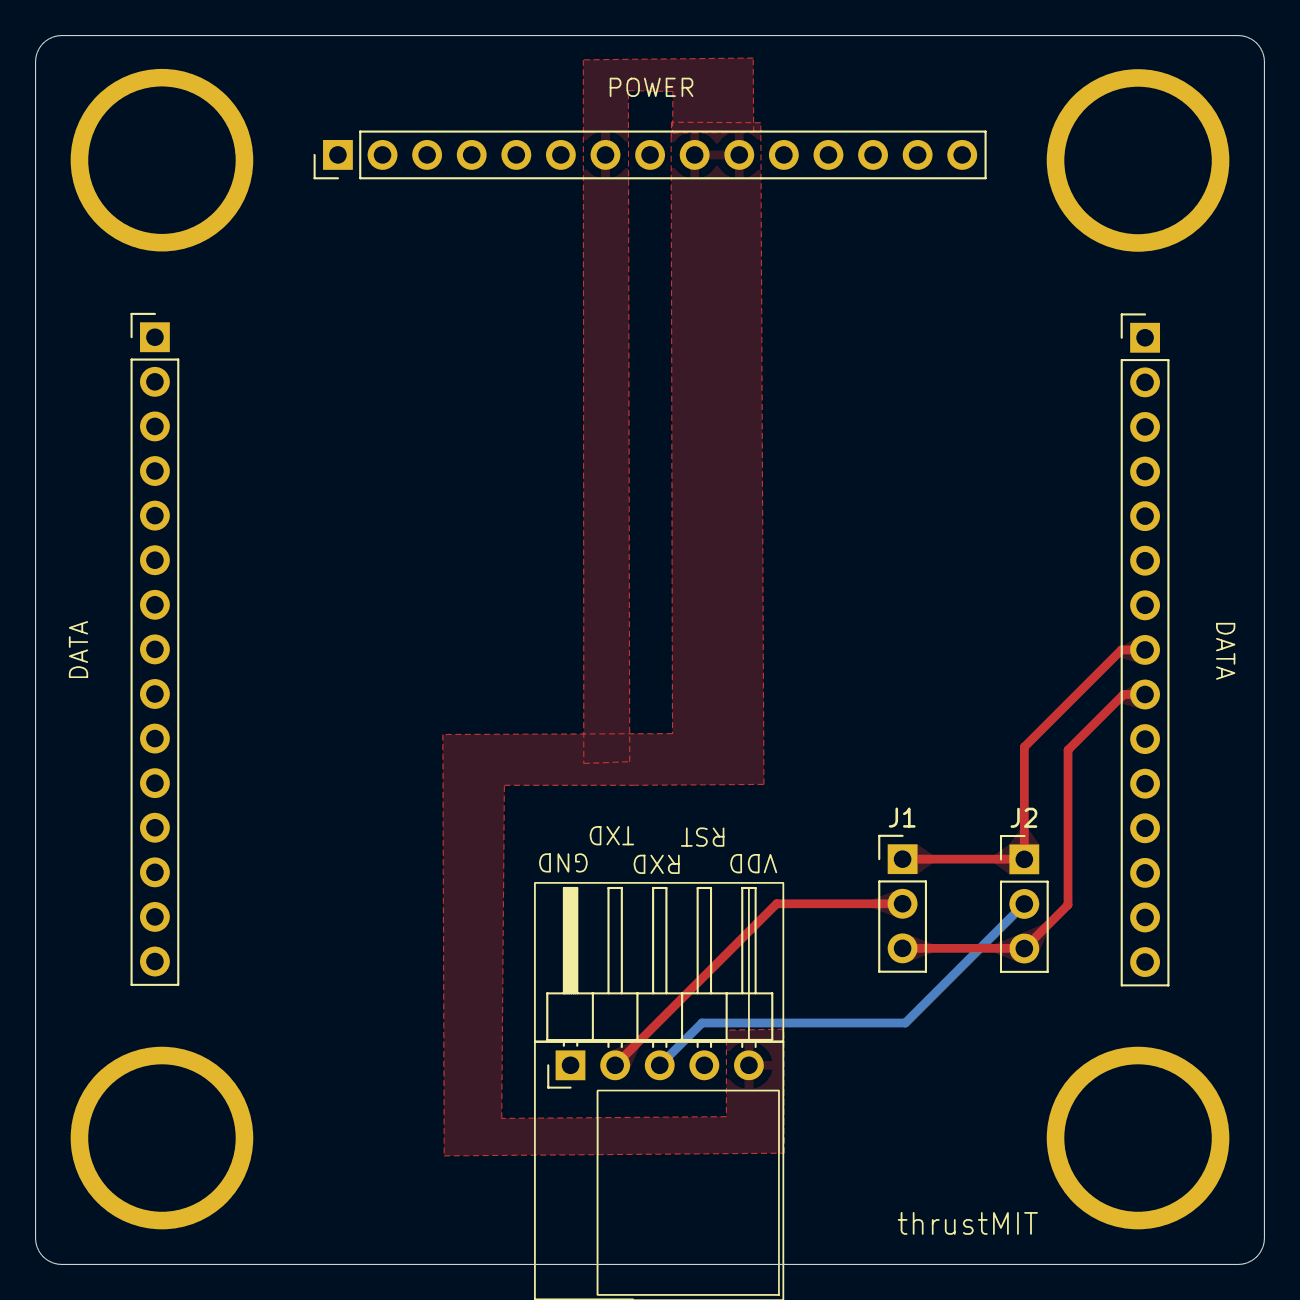
[picture p16: board Telemetry_Stack.kicad_pcb from above]

Board: 2 copper layers, 70.0 x 70.0 mm, 4 parts (0 on the bottom side), 6 nets.
