keeratrajsinghwork/Stack_based_FC_tMIT/InfyuvaControlLed#4.kicad_pcb

## KiCad design InfyuvaControlLed#4.kicad_pcb (2024-08-11)

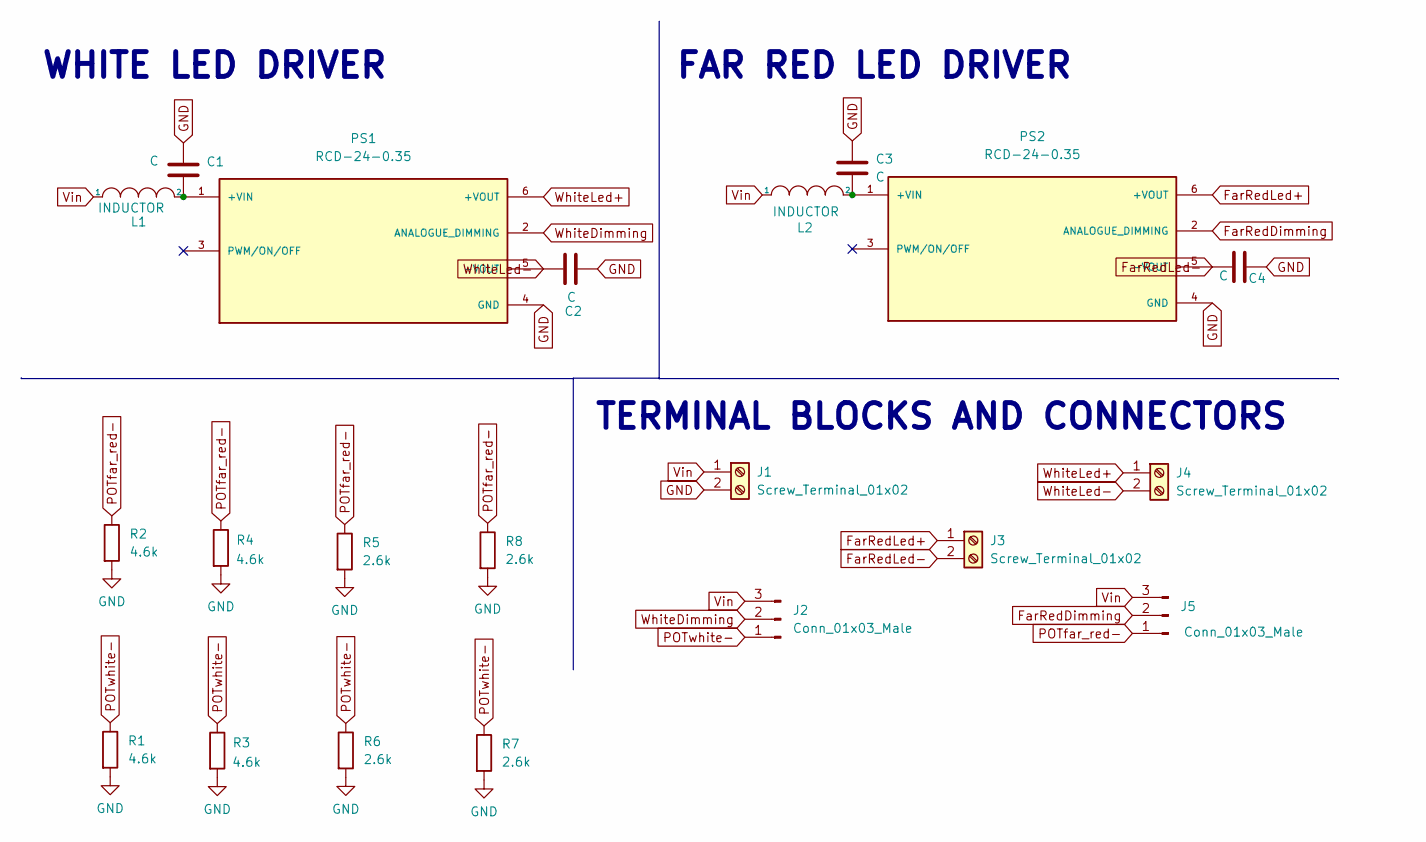
[picture p17: schematic InfyuvaControlLed#4.kicad_sch, LED driver #4(A.Das and Keeratraj Singh)]

Parts:
C1, C2, C3, C4: C; C_1206_3216Metric
J1, J3, J4: Screw_Terminal_01x02; TerminalBlock_bornier-2_P5.08mm
J2, J5: Conn_01x03_Male; FanPinHeader_1x03_P2.54mm_Vertical
L1, L2: INDUCTOR; IND_BOURNS_SRR1208
PS1, PS2: RCD-24-0.35; CONV_RCD-24-0.35; PARTREV 1
R1, R2, R3, R4: 4.6k; R_1206_3216Metric
R5, R6, R7, R8: 2.6k; R_1206_3216Metric

Connections:
FarRedDimming: J5.2, PS2.2 (ANALOGUE_DIMMING)
FarRedLed+: J3.1, PS2.6 (+VOUT)
FarRedLed-: C4.1, J3.2, PS2.5 (-VOUT)
GND: C1.2, C2.2, C3.2, C4.2, J1.2, PS1.4 (GND), PS2.4 (GND), R1.2, R2.2, R3.2, R4.2, R5.2, R6.2, R7.2, R8.2
unnamed: C1.1, L1.2, PS1.1 (+VIN)
unnamed: C3.1, L2.2, PS2.1 (+VIN)
POTfar_red-: J5.1, R2.1, R4.1, R5.1, R8.1
POTwhite-: J2.1, R1.1, R3.1, R6.1, R7.1
Vin: J1.1, J2.3, J5.3, L1.1, L2.1
WhiteDimming: J2.2, PS1.2 (ANALOGUE_DIMMING)
WhiteLed+: J4.1, PS1.6 (+VOUT)
WhiteLed-: C2.1, J4.2, PS1.5 (-VOUT)

Notes on the sheet:
FAR RED LED DRIVER
WHITE LED DRIVER
TERMINAL BLOCKS AND CONNECTORS

Board: 2 copper layers, 21 parts (1 on the bottom side), 12 nets, no tracks yet.
