keeratrajsinghwork/Stack_based_FC_tMIT/Sensor_stack/Sensor_Stack/Sensor_Stack.kicad_pcb

## KiCad design Sensor_stack/Sensor_Stack/Sensor_Stack.kicad_pcb (2024-08-11)

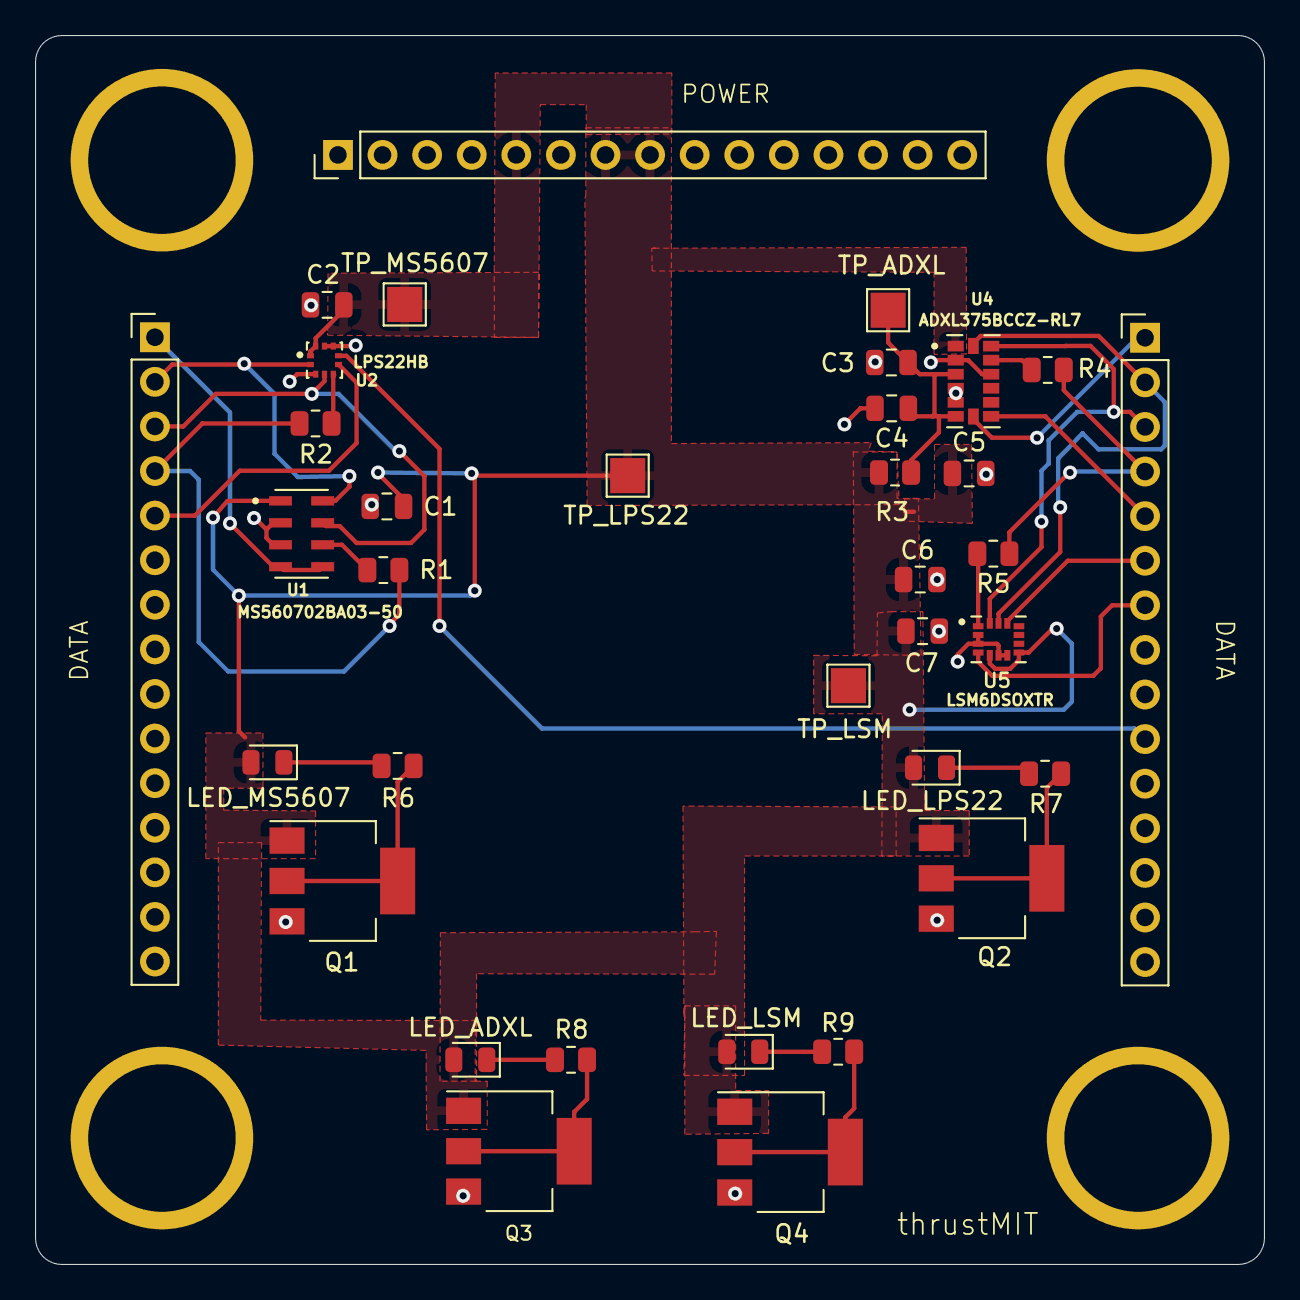
[picture p18: board Sensor_Stack.kicad_pcb from above]

Board: 2 copper layers, 70.0 x 70.0 mm, 33 parts (0 on the bottom side), 28 nets.

Parts:
C1, C2, C4, C5, C6, C7: 0.1u; C_0805_2012Metric
C3: 10u; C_0805_2012Metric
LED_ADXL: LED_IMU; LED_0805_2012Metric
LED_LPS22: LED_IMU; LED_0805_2012Metric
LED_LSM: LED_IMU; LED_0805_2012Metric
LED_MS5607: LED_IMU; LED_0805_2012Metric
Q1, Q2, Q3, Q4: PZT2222A; SOT-223-3_TabPin2
R1, R2, R4, R5: 22; R_0805_2012Metric
R3: 100; R_0805_2012Metric
R6, R7, R8, R9: 56; R_0805_2012Metric
TP_ADXL: TestPoint_Probe; TestPoint_Pad_2.0x2.0mm
TP_LPS22: TestPoint_Probe; TestPoint_Pad_2.0x2.0mm
TP_LSM: TestPoint_Probe; TestPoint_Pad_2.0x2.0mm
TP_MS5607: TestPoint_Probe; TestPoint_Pad_2.0x2.0mm
U1: MS560702BA03-50
U2: LPS22HB
U4: ADXL375BCCZ-RL7
U5: LSM6DSOXTR
U6: FC_Stack_template

Connections:
3.3V: C1.1, C2.1, C5.1, C6.2, C7.1, LED_ADXL.2 (A), LED_LPS22.2 (A), LED_LSM.2 (A), LED_MS5607.2 (A), Q1.1 (B), Q2.1 (B), Q3.1 (B), Q4.1 (B), R3.1, TP_LPS22.1, TP_LSM.1, TP_MS5607.1, U1.1 (VDD), U2.1 (VDD_IO), U2.10 (VDD), U4.1 (Vdd/io), U5.5 (VDDIO), U5.8 (VDD), U6.35, U6.37, U6.38
CS_ADXL: U4.7 (CS), U6.1
CS_LPS: U2.6 (CS), U6.26
CS_LSM: U5.12 (CS), U6.6
CS_MS5607: U1.4 (~CSB), U1.5 (~CSB), U6.30
GND: C1.2, C2.2, C3.2, C4.2, C5.2, C6.1, C7.2, Q1.3 (E), Q2.3 (E), Q3.3 (E), Q4.3 (E), U1.2 (PS), U1.3 (GND), U2.3 (RES), U2.8 (GND), U2.9 (GND), U4.2 (GND), U4.4 (GND), U4.5 (GND), U4.11 (Reserved), U5.2 (SDX), U5.3 (SCX), U5.6 (GND), U5.7 (GND), U6.49 (1), U6.50 (1), U6.51 (1), U6.52 (1)
INT_ADXL: U4.8 (INT1), U6.5
INT_LPS: U2.7 (INT_DRDY), U6.10
INT_LSM: U5.4 (INT1), U6.7
MISO_SPI1: R1.2, R2.1, U6.27
MISO_SPI2: R4.2, R5.1, U6.4
MOSI_SPI1: U1.7 (SDI/SDA), U2.4 (SDA/SDI/SDO), U6.28
MOSI_SPI2: U4.13 (SDA/SDI/SDIO), U5.14 (SDA), U6.3
unnamed: LED_MS5607.1 (K), R6.1
unnamed: LED_LPS22.1 (K), R7.1
unnamed: LED_ADXL.1 (K), R8.1
unnamed: LED_LSM.1 (K), R9.1
unnamed: Q1.2 (C), R6.2
unnamed: Q2.2 (C), R7.2
unnamed: Q3.2 (C), R8.2
unnamed: Q4.2 (C), R9.2
unnamed: R1.1, U1.6 (SDO)
unnamed: R2.2, U2.5 (SDO/SA0)
unnamed: R4.1, U4.12 (SDO)
unnamed: C3.1, C4.1, R3.2, TP_ADXL.1, U4.3 (Reserved), U4.6 (Vs)
unnamed: R5.2, U5.1 (SDO/SA0)
SCLK_SPI1: U1.8 (SCLK), U2.2 (SCL/SPC), U6.29
SCLK_SPI2: U4.14 (SCL/SCLK), U5.13 (SCL), U6.2
