keeratrajsinghwork/Stack_based_FC_tMIT/MC_stack/MC_stack.kicad_pcb

## KiCad design MC_stack/MC_stack.kicad_pcb (2024-08-11)

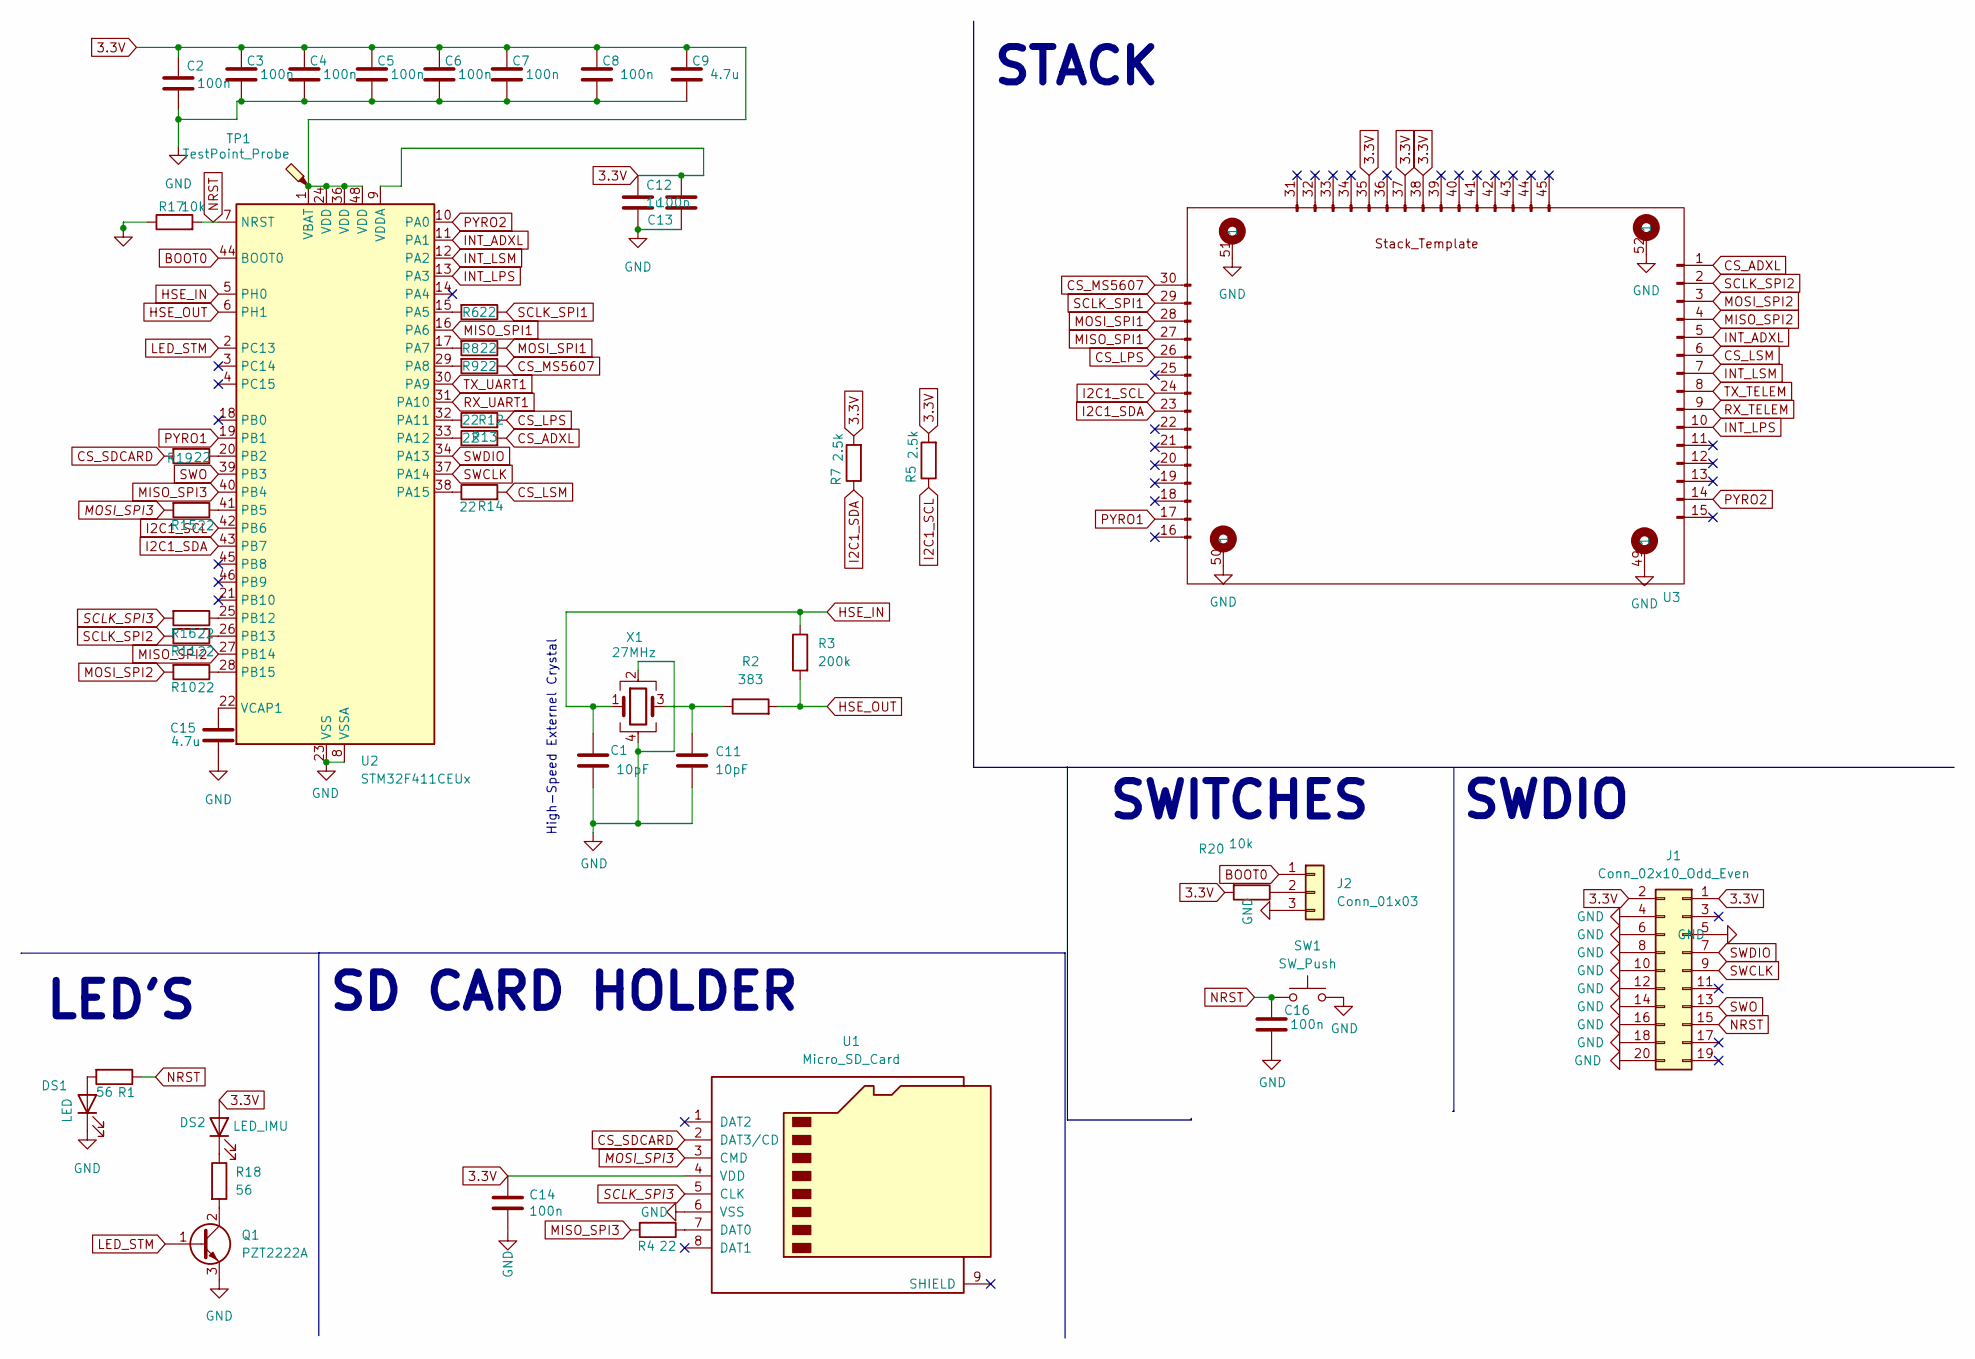
[picture p19: schematic MC_stack.kicad_sch]

Parts:
C1, C11: 10pF; C_0805_2012Metric
C2, C3, C4, C5, C6, C7, C8, C12, C14, C16: 100n; C_0805_2012Metric
C9, C15: 4.7u; C_0805_2012Metric
C13: 1u; C_0805_2012Metric
DS1: LED; LED_0805_2012Metric
DS2: LED_IMU; LED_0805_2012Metric
J1: Conn_02x10_Odd_Even; PinHeader_2x10_P2.54mm_Vertical
J2: Conn_01x03; PinHeader_1x03_P2.54mm_Vertical
Q1: PZT2222A; SOT-223-3_TabPin2
R1, R18: 56; R_0805_2012Metric
R2: 383; R_0805_2012Metric
R3: 200k; R_0805_2012Metric
R4, R6, R8, R9, R10, R11, R12, R13, R14, R15, R16, R19: 22; R_0805_2012Metric
R5, R7: 2.5k; R_0805_2012Metric
R17, R20: 10k; R_0805_2012Metric
SW1: SW_Push; SW_Push_SPST_NO_Alps_SKRK
TP1: TestPoint_Probe; TestPoint_Pad_2.0x2.0mm
U1: Micro_SD_Card; microSD_HC_Molex_104031-0811
U2: STM32F411CEUx; QFN-48-1EP_7x7mm_P0.5mm_EP5.6x5.6mm
U3: FC_Stack_template
X1: 27MHz; Crystal_SMD_Abracon_ABM8G-4Pin_3.2x2.5mm

Connections:
3.3V: C2.1, C3.1, C4.1, C5.1, C6.1, C7.1, C8.1, C9.1, C12.1, C13.2, C14.1, DS2.2 (A), J1.1, J1.2, R5.2, R7.2, R20.2, TP1.1, U1.4 (VDD), U2.1 (VBAT), U2.9 (VDDA), U2.24 (VDD), U2.36 (VDD), U2.48 (VDD), U3.35, U3.37, U3.38
BOOT0: J2.1, U2.44 (BOOT0)
CS_ADXL: R13.2, U3.1
CS_LPS: R12.2, U3.26
CS_LSM: R14.2, U3.6
CS_MS5607: R9.1, U3.30
CS_SDCARD: R19.2, U1.2 (DAT3/CD)
GND: C1.2, C2.2, C3.2, C4.2, C5.2, C6.2, C7.2, C8.2, C9.2, C11.2, C12.2, C13.1, C14.2, C15.2, C16.2, DS1.1 (K), J1.4, J1.5, J1.6, J1.8, J1.10, J1.12, J1.14, J1.16, J1.18, J1.20, J2.3, Q1.3 (E), R17.1, SW1.2, U1.6 (VSS), U2.8 (VSSA), U2.23 (VSS), U2.35 (VSS), U2.47 (VSS), U2.49 (VSS), U3.49 (1), U3.50 (1), U3.51 (1), U3.52 (1), X1.2, X1.4
HSE_IN: C1.1, R3.1, U2.5 (PH0), X1.1
HSE_OUT: R2.2, R3.2, U2.6 (PH1)
I2C1_SCL: R5.1, U2.42 (PB6), U3.24
I2C1_SDA: R7.1, U2.43 (PB7), U3.23
INT_ADXL: U2.11 (PA1), U3.5
INT_LPS: U2.13 (PA3), U3.10
INT_LSM: U2.12 (PA2), U3.7
LED_STM: Q1.1 (B), U2.2 (PC13)
MISO_SPI1: U2.16 (PA6), U3.27
MISO_SPI2: U2.27 (PB14), U3.4
MISO_SPI3: R4.2, U2.40 (PB4)
MOSI_SPI1: R8.1, U3.28
MOSI_SPI2: R10.2, U3.3
MOSI_SPI3: R15.2, U1.3 (CMD)
NRST: C16.1, J1.15, R1.1, R17.2, SW1.1, U2.7 (NRST)
unnamed: C11.1, R2.1, X1.3
unnamed: DS1.2 (A), R1.2
unnamed: DS2.1 (K), R18.1
unnamed: J2.2, R20.1
unnamed: Q1.2 (C), R18.2
unnamed: R4.1, U1.7 (DAT0)
unnamed: R6.2, U2.15 (PA5)
unnamed: R8.2, U2.17 (PA7)
unnamed: R9.2, U2.29 (PA8)
unnamed: R12.1, U2.32 (PA11)
unnamed: R13.1, U2.33 (PA12)
unnamed: R14.1, U2.38 (PA15)
unnamed: R19.1, U2.20 (PB2)
unnamed: R15.1, U2.41 (PB5)
unnamed: R16.1, U2.25 (PB12)
unnamed: R11.1, U2.26 (PB13)
unnamed: R10.1, U2.28 (PB15)
unnamed: C15.1, U2.22 (VCAP1)
RX_TELEM: U3.9
RX_UART1: U2.31 (PA10)
SCLK_SPI1: R6.1, U3.29
SCLK_SPI2: R11.2, U3.2
SCLK_SPI3: R16.2, U1.5 (CLK)
SWCLK: J1.9, U2.37 (PA14)
SWDIO: J1.7, U2.34 (PA13)
SWO: J1.13, U2.39 (PB3)
TX_TELEM: U3.8
TX_UART1: U2.30 (PA9)

Notes on the sheet:
SWDIO
LED'S
High-Speed Externel Crystal
SD CARD HOLDER
STACK
SWITCHES

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
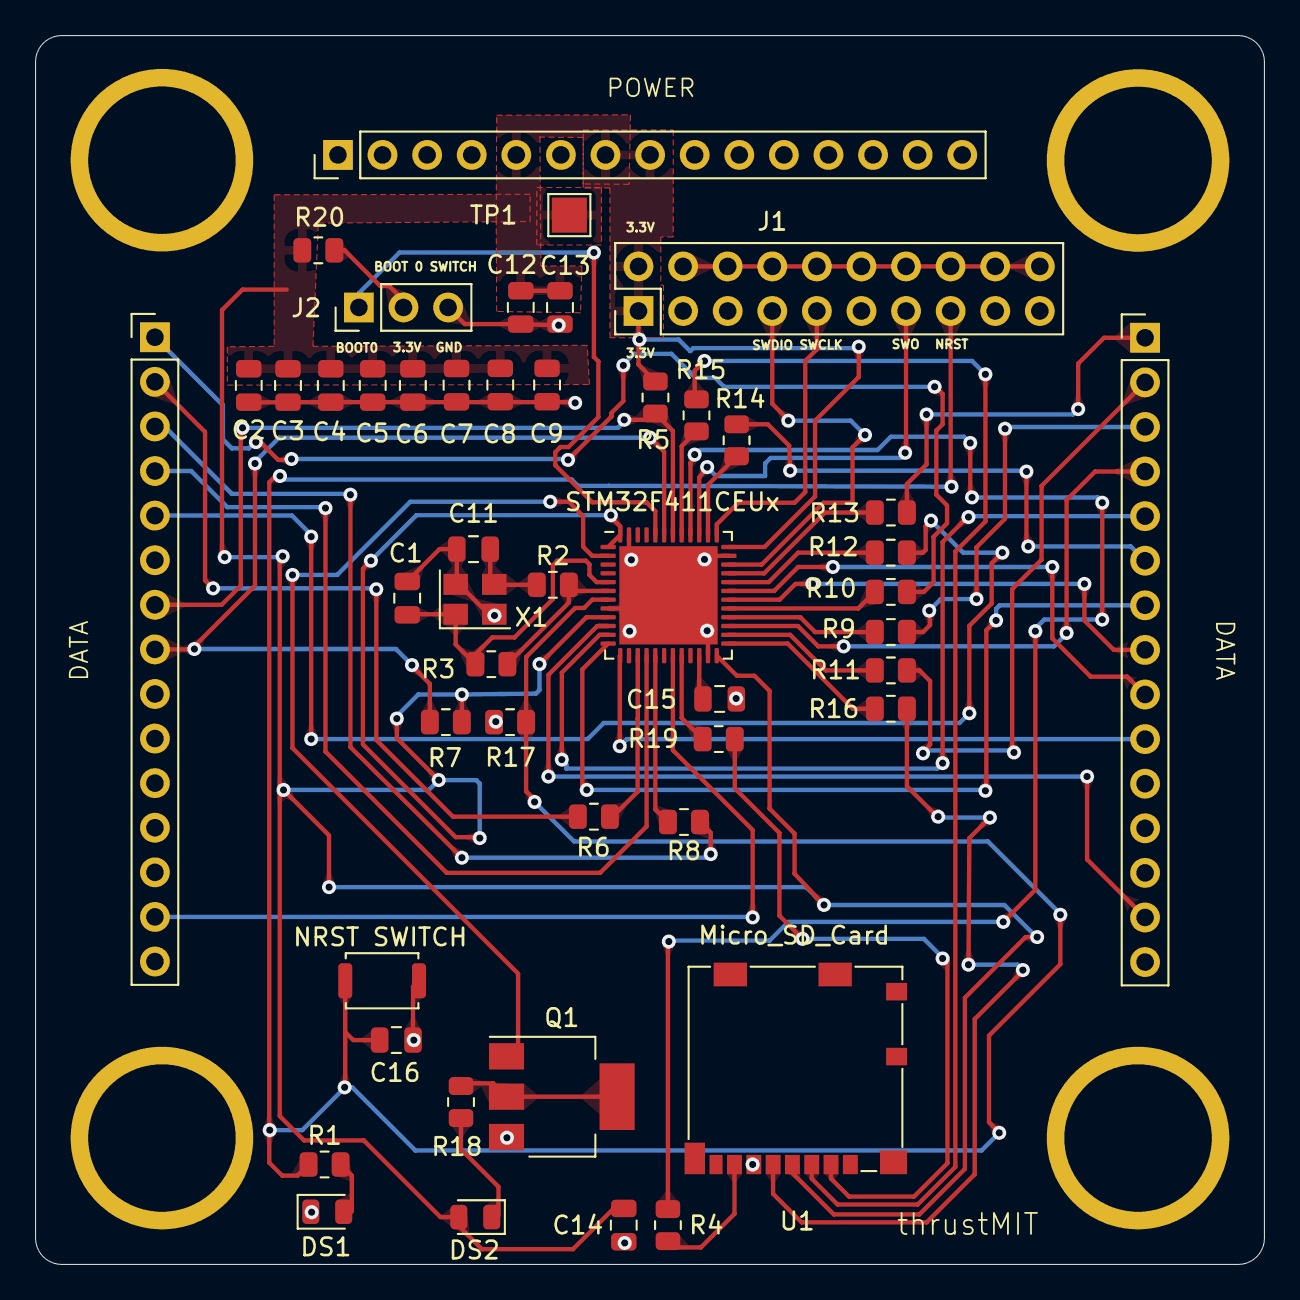
[picture p20: board MC_stack.kicad_pcb from above]

Board: 2 copper layers, 70.0 x 70.0 mm, 46 parts (0 on the bottom side), 47 nets.
