keeratrajsinghwork/Stack_based_FC_tMIT/PDB/PDB_Board.kicad_pcb

## KiCad design PDB/PDB_Board.kicad_pcb (2024-08-11)

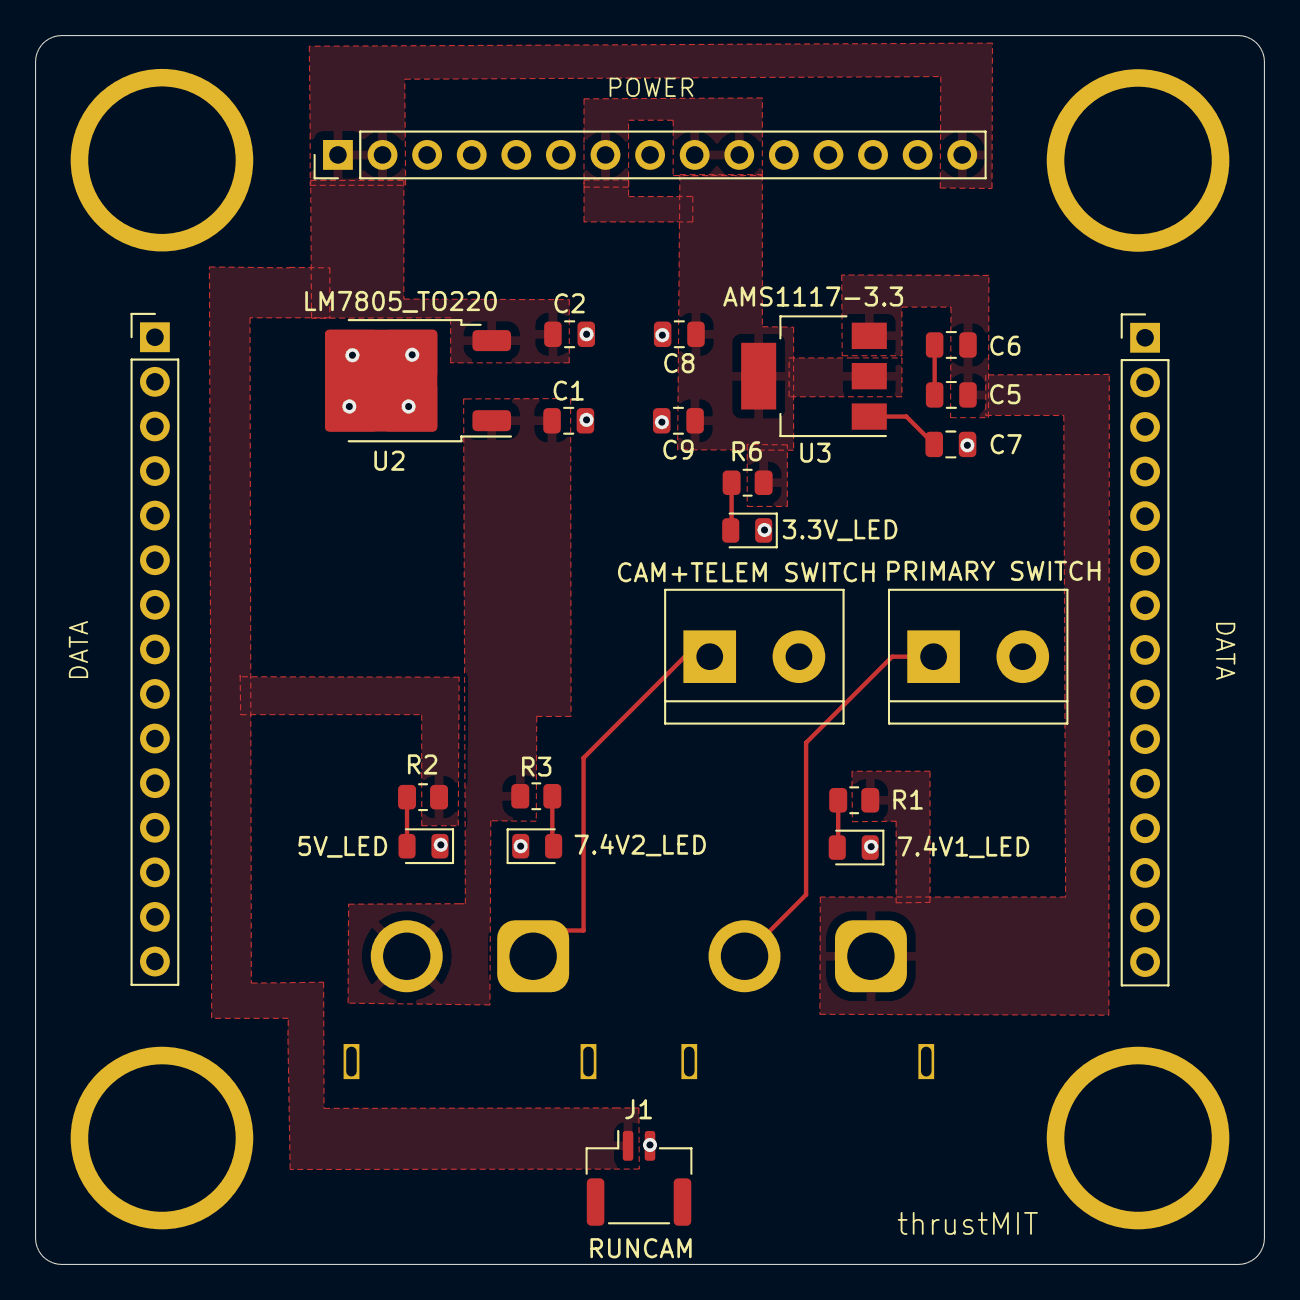
[picture p21: board PDB_Board.kicad_pcb from above]

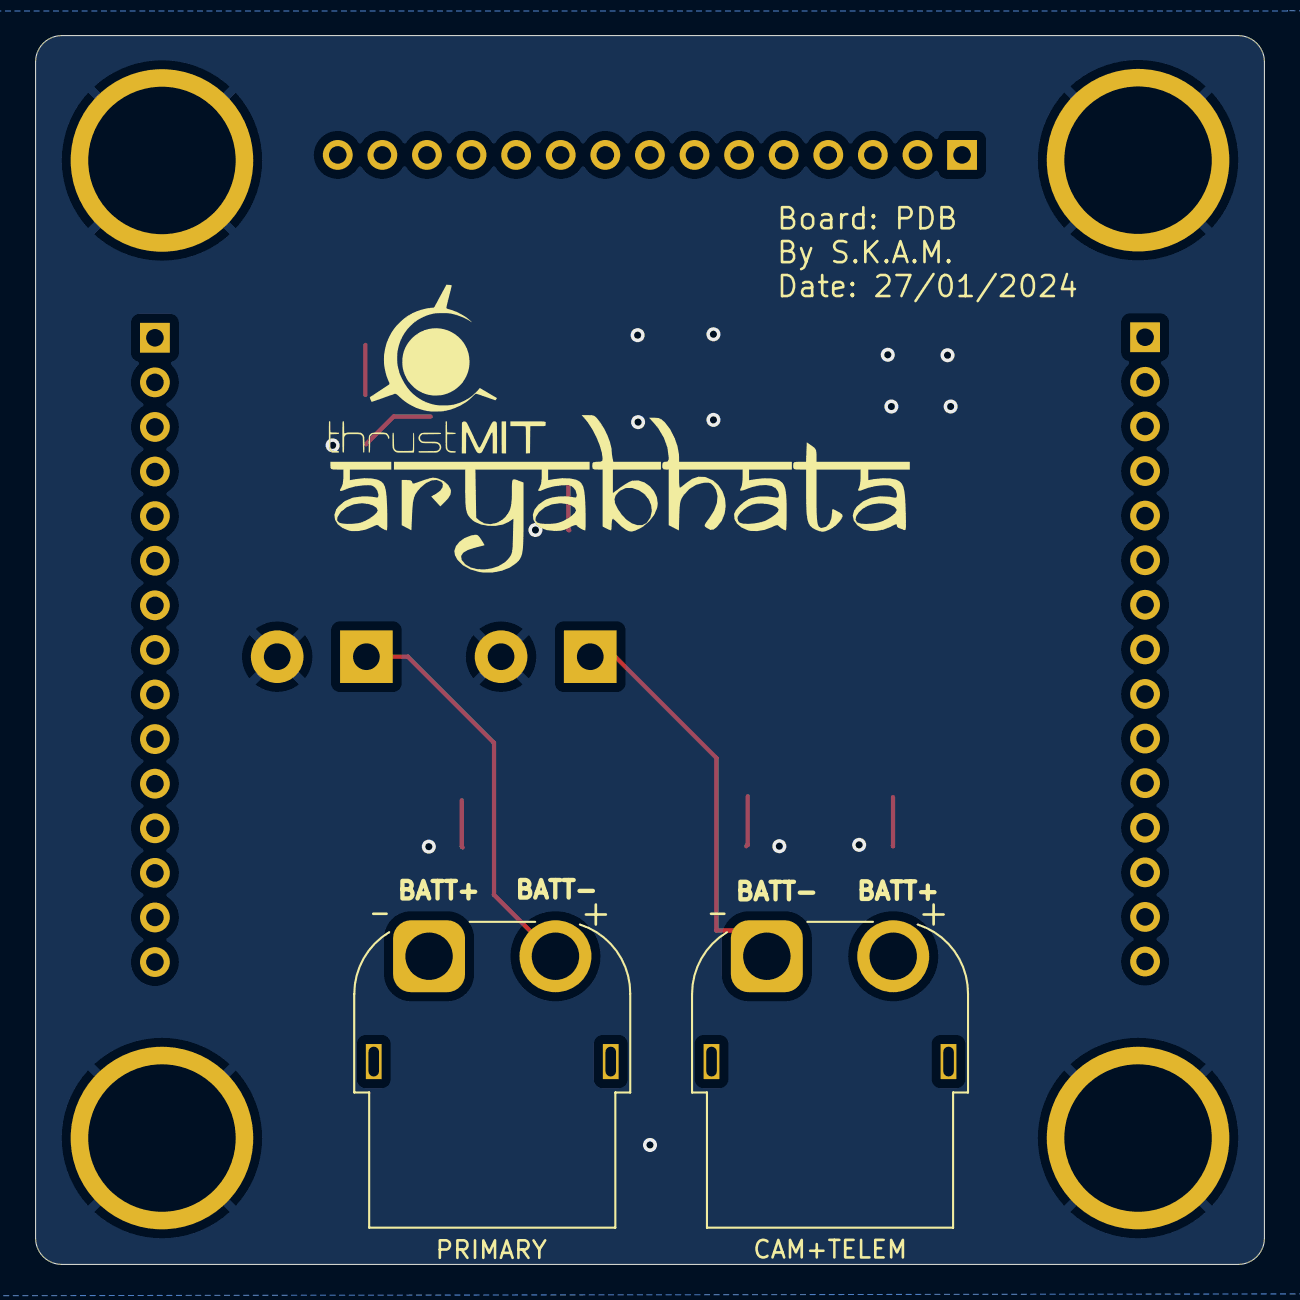
[picture p22: board PDB_Board.kicad_pcb from below]

Board: 2 copper layers, 70.0 x 70.0 mm, 23 parts (2 on the bottom side), 13 nets.

Parts:
3.3V_LED, 5V_LED, 7.4V1_LED, 7.4V2_LED: LED; LED_0805_2012Metric
C1: 0.33u; C_0805_2012Metric
C2: 0.1u; C_0805_2012Metric
C5, C8: 10u; C_0805_2012Metric
C6, C7, C9: 100nF; C_0805_2012Metric
CAM+TELEM: Conn_01x02_Pin; AMASS_XT60PW-F_1x02_P7.20mm_Horizontal
CAM+TELEM SWITCH: Screw_Terminal_01x02; TerminalBlock_bornier-2_P5.08mm
J1: Conn_01x02_Pin; JST_GH_SM02B-GHS-TB_1x02-1MP_P1.25mm_Horizontal
PRIMARY: Conn_01x02_Pin; AMASS_XT60PW-F_1x02_P7.20mm_Horizontal
PRIMARY SWITCH: Screw_Terminal_01x02; TerminalBlock_bornier-2_P5.08mm
R1, R2, R3: 220; R_0805_2012Metric
R6: 56; R_0805_2012Metric
U1: FC_stack; FC_Stack_template
U2: LM7805_TO220; TO-252-2
U3: AMS1117-3.3; SOT-223-3_TabPin2

Connections:
3.3V: C8.1, C9.1, R6.1, U1.37, U1.39, U1.40, U3.2 (VO)
5V: C2.1, J1.1, R2.1, U1.31, U1.32, U1.45, U2.3 (VO)
7.4V1: C5.1, C6.1, PRIMARY.1, R1.1, U3.3 (VI)
7.4V1_SWITCH: PRIMARY.2, PRIMARY SWITCH.1
7.4V2: C1.1, CAM+TELEM.2, R3.1, U2.1 (VI)
7.4V2_SWITCH: CAM+TELEM.1, CAM+TELEM SWITCH.1
GND: 3.3V_LED.1 (K), 5V_LED.1 (K), 7.4V1_LED.1 (K), 7.4V2_LED.1 (K), C1.2, C2.2, C7.2, C8.2, C9.2, CAM+TELEM SWITCH.2, J1.2, PRIMARY SWITCH.2, U1.49 (1), U1.50 (1), U1.51 (1), U1.52 (1), U2.2 (GND)
unnamed: C5.2, C6.2
unnamed: 7.4V1_LED.2 (A), R1.2
unnamed: 5V_LED.2 (A), R2.2
unnamed: 7.4V2_LED.2 (A), R3.2
unnamed: 3.3V_LED.2 (A), R6.2
unnamed: C7.1, U3.1 (GND)
