keeratrajsinghwork/Stack_based_FC_tMIT/fc_tht/FC_THT_STACK/FC_THT_STACK.kicad_pcb

## KiCad design fc_tht/FC_THT_STACK/FC_THT_STACK.kicad_pcb (2024-08-11)

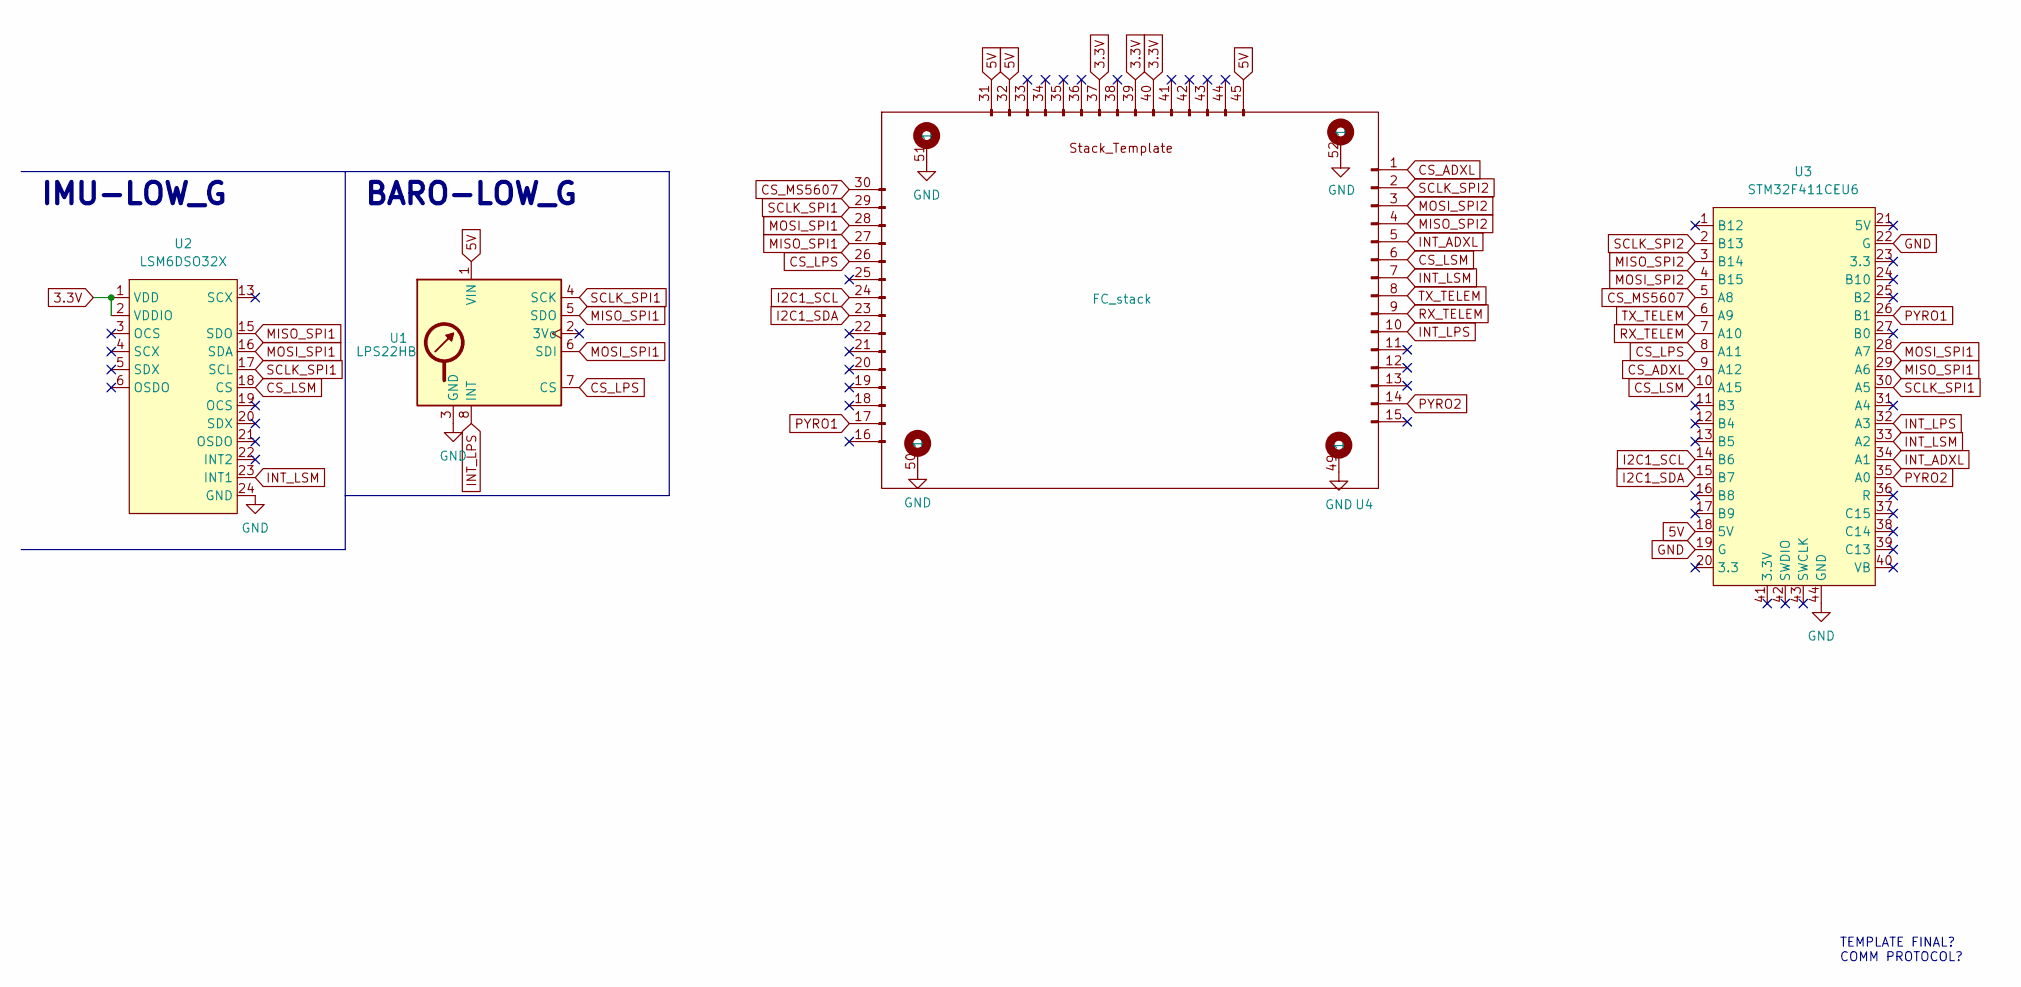
[picture p23: schematic FC_THT_STACK.kicad_sch]

Parts:
U1: LPS22HB; LPS22HB_ThrustMIT
U2: LSM6DSO32X
U3: STM32F411CEU6
U4: FC_stack; FC_Stack_template

Connections:
3.3V: U2.1 (VDD), U2.2 (VDDIO), U4.37, U4.39, U4.40
5V: U1.1 (VIN), U3.18 (5V), U4.31, U4.32, U4.45
CS_ADXL: U3.9 (A12), U4.1
CS_LPS: U1.7 (CS), U3.8 (A11), U4.26
CS_LSM: U2.18 (CS), U3.10 (A15), U4.6
CS_MS5607: U3.5 (A8), U4.30
GND: U1.3 (GND), U2.24 (GND), U3.19 (G), U3.22 (G), U3.44 (GND), U4.49 (1), U4.50 (1), U4.51 (1), U4.52 (1)
I2C1_SCL: U3.14 (B6), U4.24
I2C1_SDA: U3.15 (B7), U4.23
INT_ADXL: U3.34 (A1), U4.5
INT_LPS: U1.8 (INT), U3.32 (A3), U4.10
INT_LSM: U2.23 (INT1), U3.33 (A2), U4.7
MISO_SPI1: U1.5 (SDO), U2.15 (SDO), U3.29 (A6), U4.27
MISO_SPI2: U3.3 (B14), U4.4
MOSI_SPI1: U1.6 (SDI), U2.16 (SDA), U3.28 (A7), U4.28
MOSI_SPI2: U3.4 (B15), U4.3
PYRO1: U3.26 (B1), U4.17
PYRO2: U3.35 (A0), U4.14
RX_TELEM: U3.7 (A10), U4.9
SCLK_SPI1: U1.4 (SCK), U2.17 (SCL), U3.30 (A5), U4.29
SCLK_SPI2: U3.2 (B13), U4.2
TX_TELEM: U3.6 (A9), U4.8

Notes on the sheet:
TEMPLATE FINAL? COMM PROTOCOL?
BARO-LOW_G
IMU-LOW_G

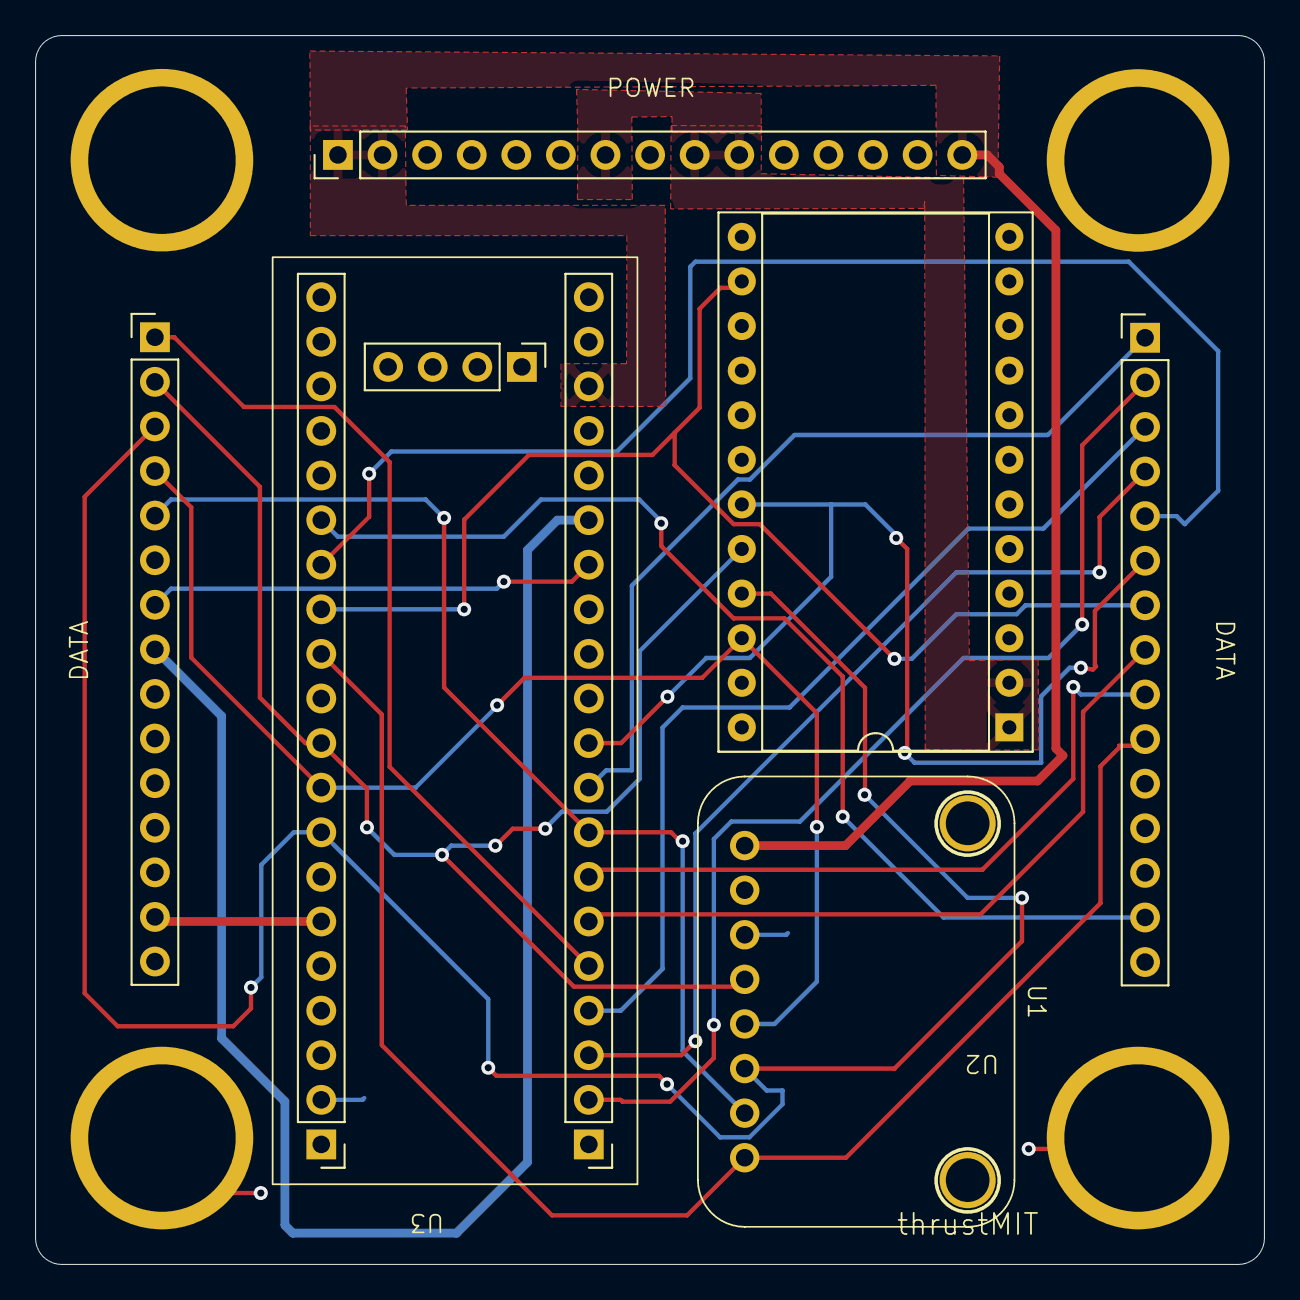
[picture p24: board FC_THT_STACK.kicad_pcb from above]

Board: 2 copper layers, 70.0 x 70.0 mm, 4 parts (0 on the bottom side), 22 nets.
