keeratrajsinghwork/Stack_based_FC_tMIT/GPS_Stack/GPS_Stack.kicad_pcb

## KiCad design GPS_Stack/GPS_Stack.kicad_pcb (2024-08-11)

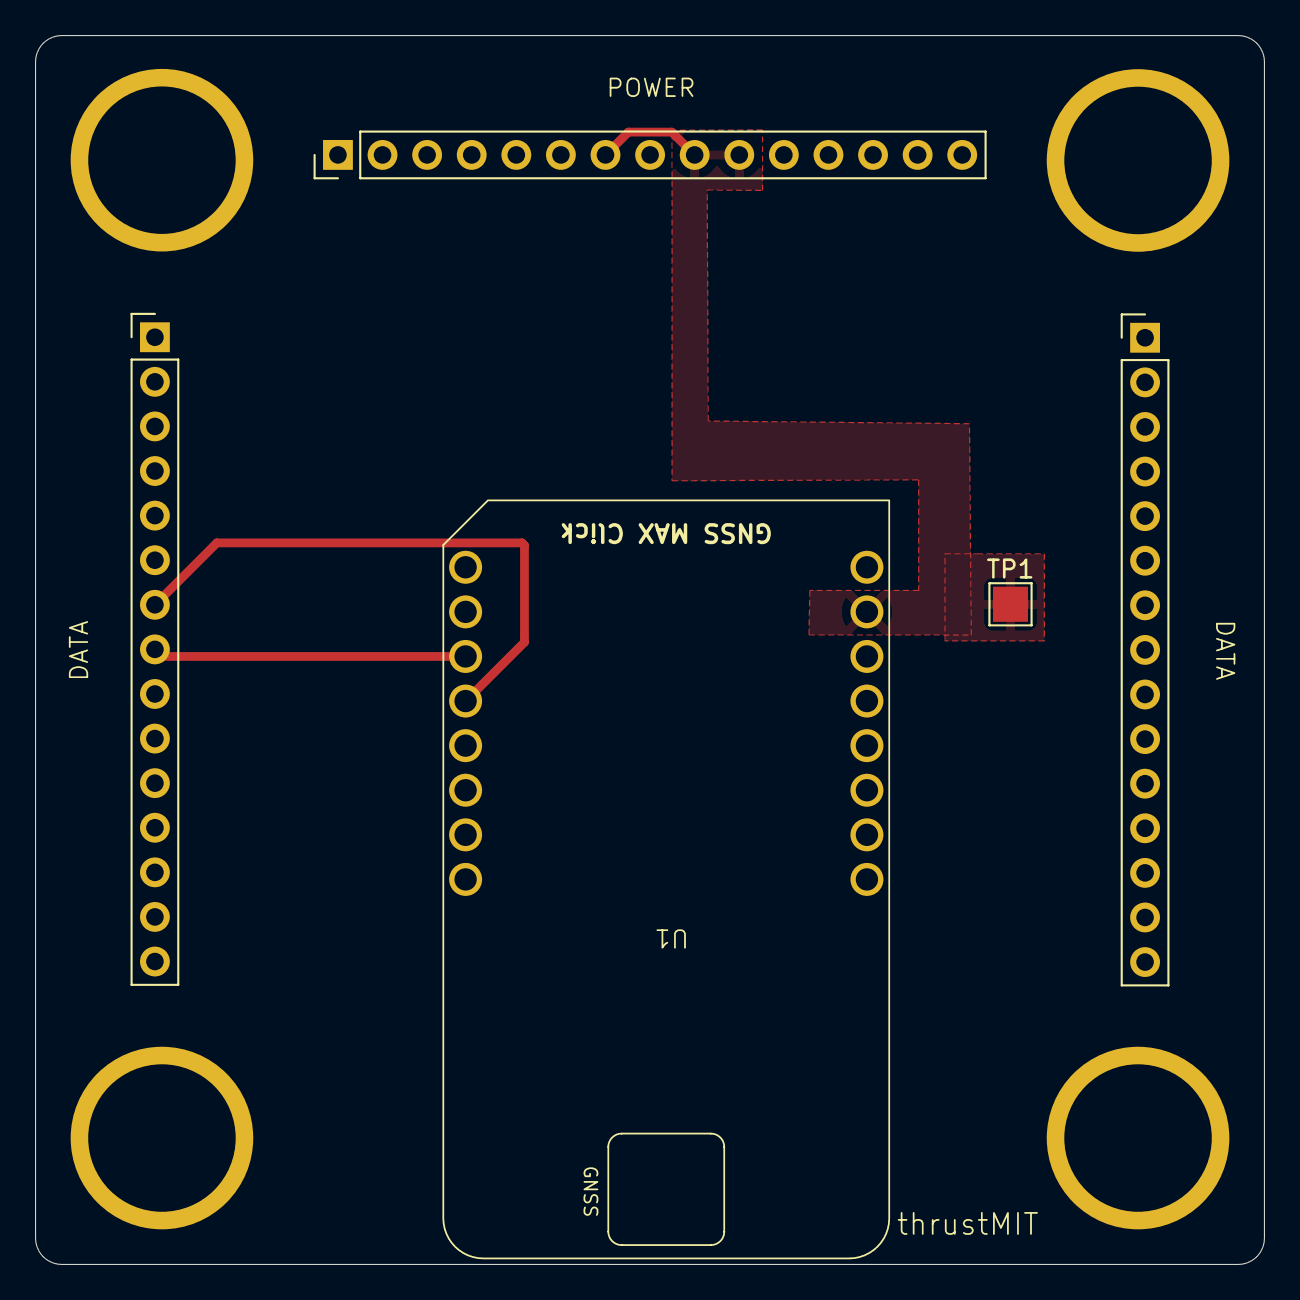
[picture p25: board GPS_Stack.kicad_pcb from above]

Board: 2 copper layers, 70.0 x 70.0 mm, 3 parts (0 on the bottom side), 4 nets.

Parts:
TP1: TestPoint_Probe; TestPoint_Pad_2.0x2.0mm
U1: Mikroe_GNSS_MAX_CLICK_ThrustMIT
U2: FC_Stack_template

Connections:
3.3V: TP1.1, U1.2 (+3V3), U2.37, U2.39, U2.40
GND: U1.1 (GND), U1.9 (GND), U2.49 (1), U2.50 (1), U2.51 (1), U2.52 (1)
I2C1_SCL: U1.12 (SCL), U2.24
I2C1_SDA: U1.11 (SDA), U2.23
