keeratrajsinghwork/Stack_based_FC_tMIT/fc_tht/FC_THT_STACK_2/FC_THT_STACK_2.kicad_pcb

## KiCad design fc_tht/FC_THT_STACK_2/FC_THT_STACK_2.kicad_pcb (2024-08-11)

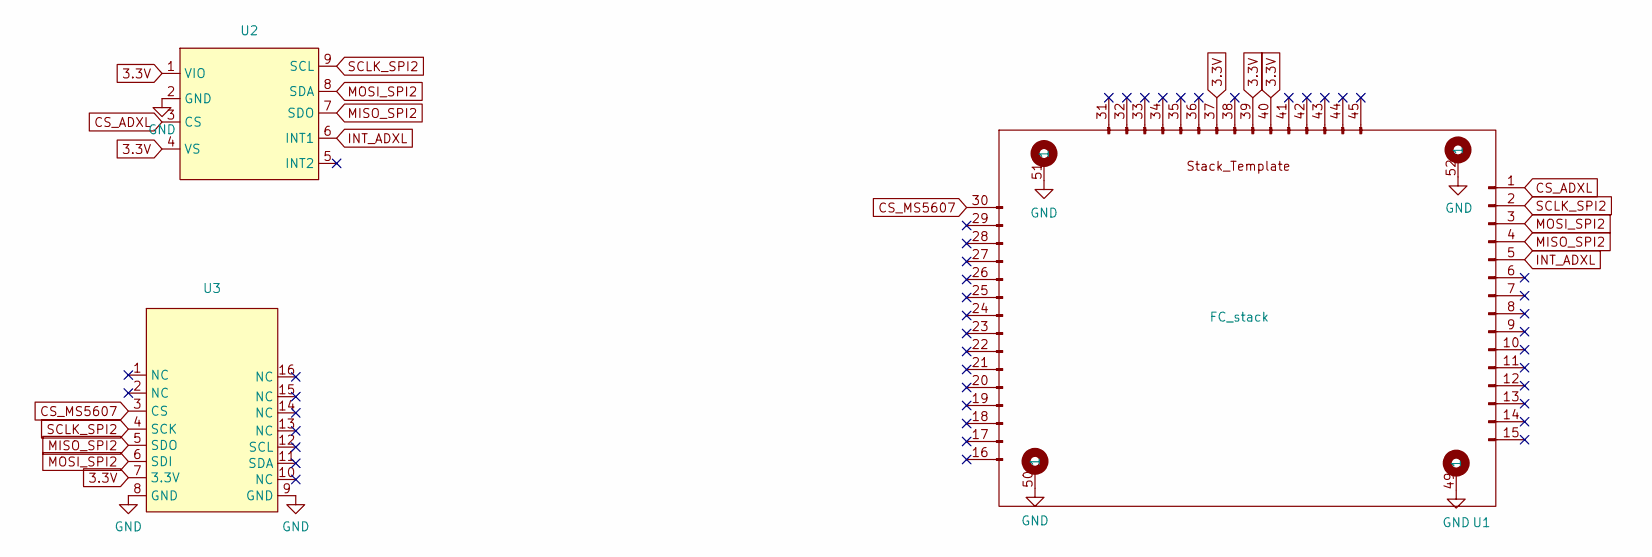
[picture p26: schematic FC_THT_STACK_2.kicad_sch]

Parts:
U1: FC_stack; FC_Stack_template
U2: ADXL375_EVAL
U3: Altitude_Click_2

Connections:
3.3V: U1.37, U1.39, U1.40, U2.1 (VIO), U2.4 (VS), U3.7 (3.3V)
CS_ADXL: U1.1, U2.3 (CS)
CS_MS5607: U1.30, U3.3 (CS)
GND: U1.49 (1), U1.50 (1), U1.51 (1), U1.52 (1), U2.2 (GND), U3.8 (GND), U3.9 (GND)
INT_ADXL: U1.5, U2.6 (INT1)
MISO_SPI2: U1.4, U2.7 (SDO), U3.5 (SDO)
MOSI_SPI2: U1.3, U2.8 (SDA), U3.6 (SDI)
SCLK_SPI2: U1.2, U2.9 (SCL), U3.4 (SCK)

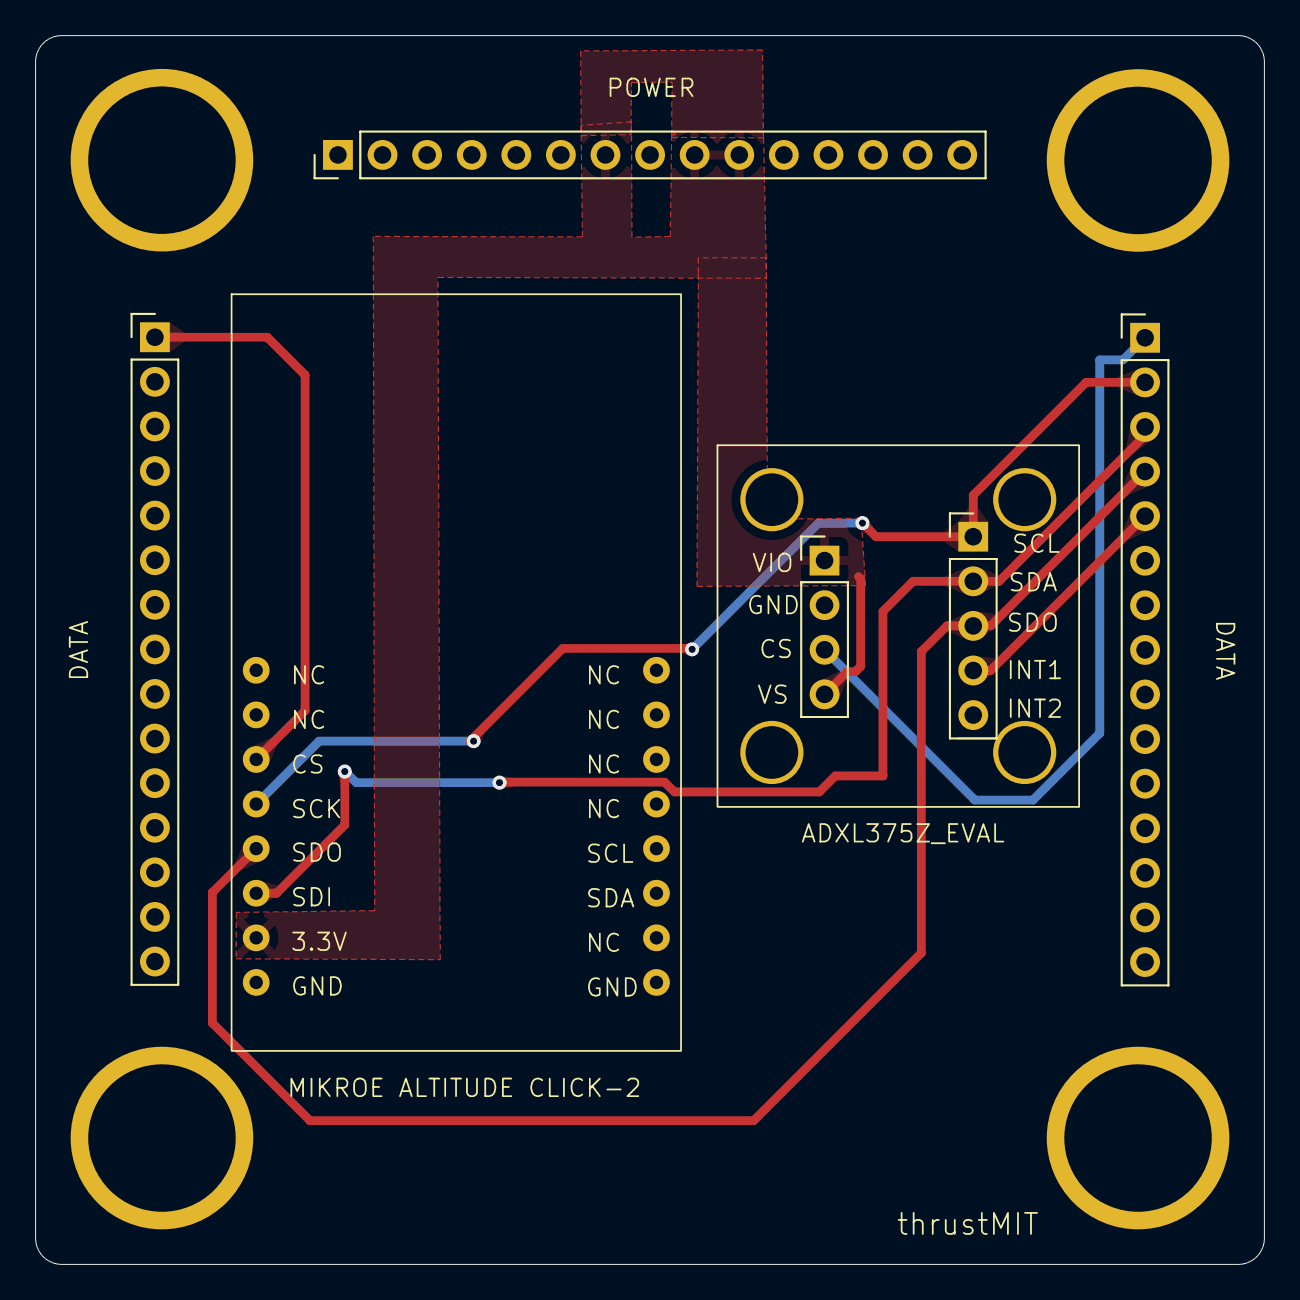
[picture p27: board FC_THT_STACK_2.kicad_pcb from above]

Board: 2 copper layers, 70.0 x 70.0 mm, 3 parts (0 on the bottom side), 8 nets.
