keeratrajsinghwork/Stack_based_FC_tMIT/GPIO_stack/GPIO_stack/GPIO_stack.kicad_pcb

## KiCad design GPIO_stack/GPIO_stack/GPIO_stack.kicad_pcb (2024-08-11)

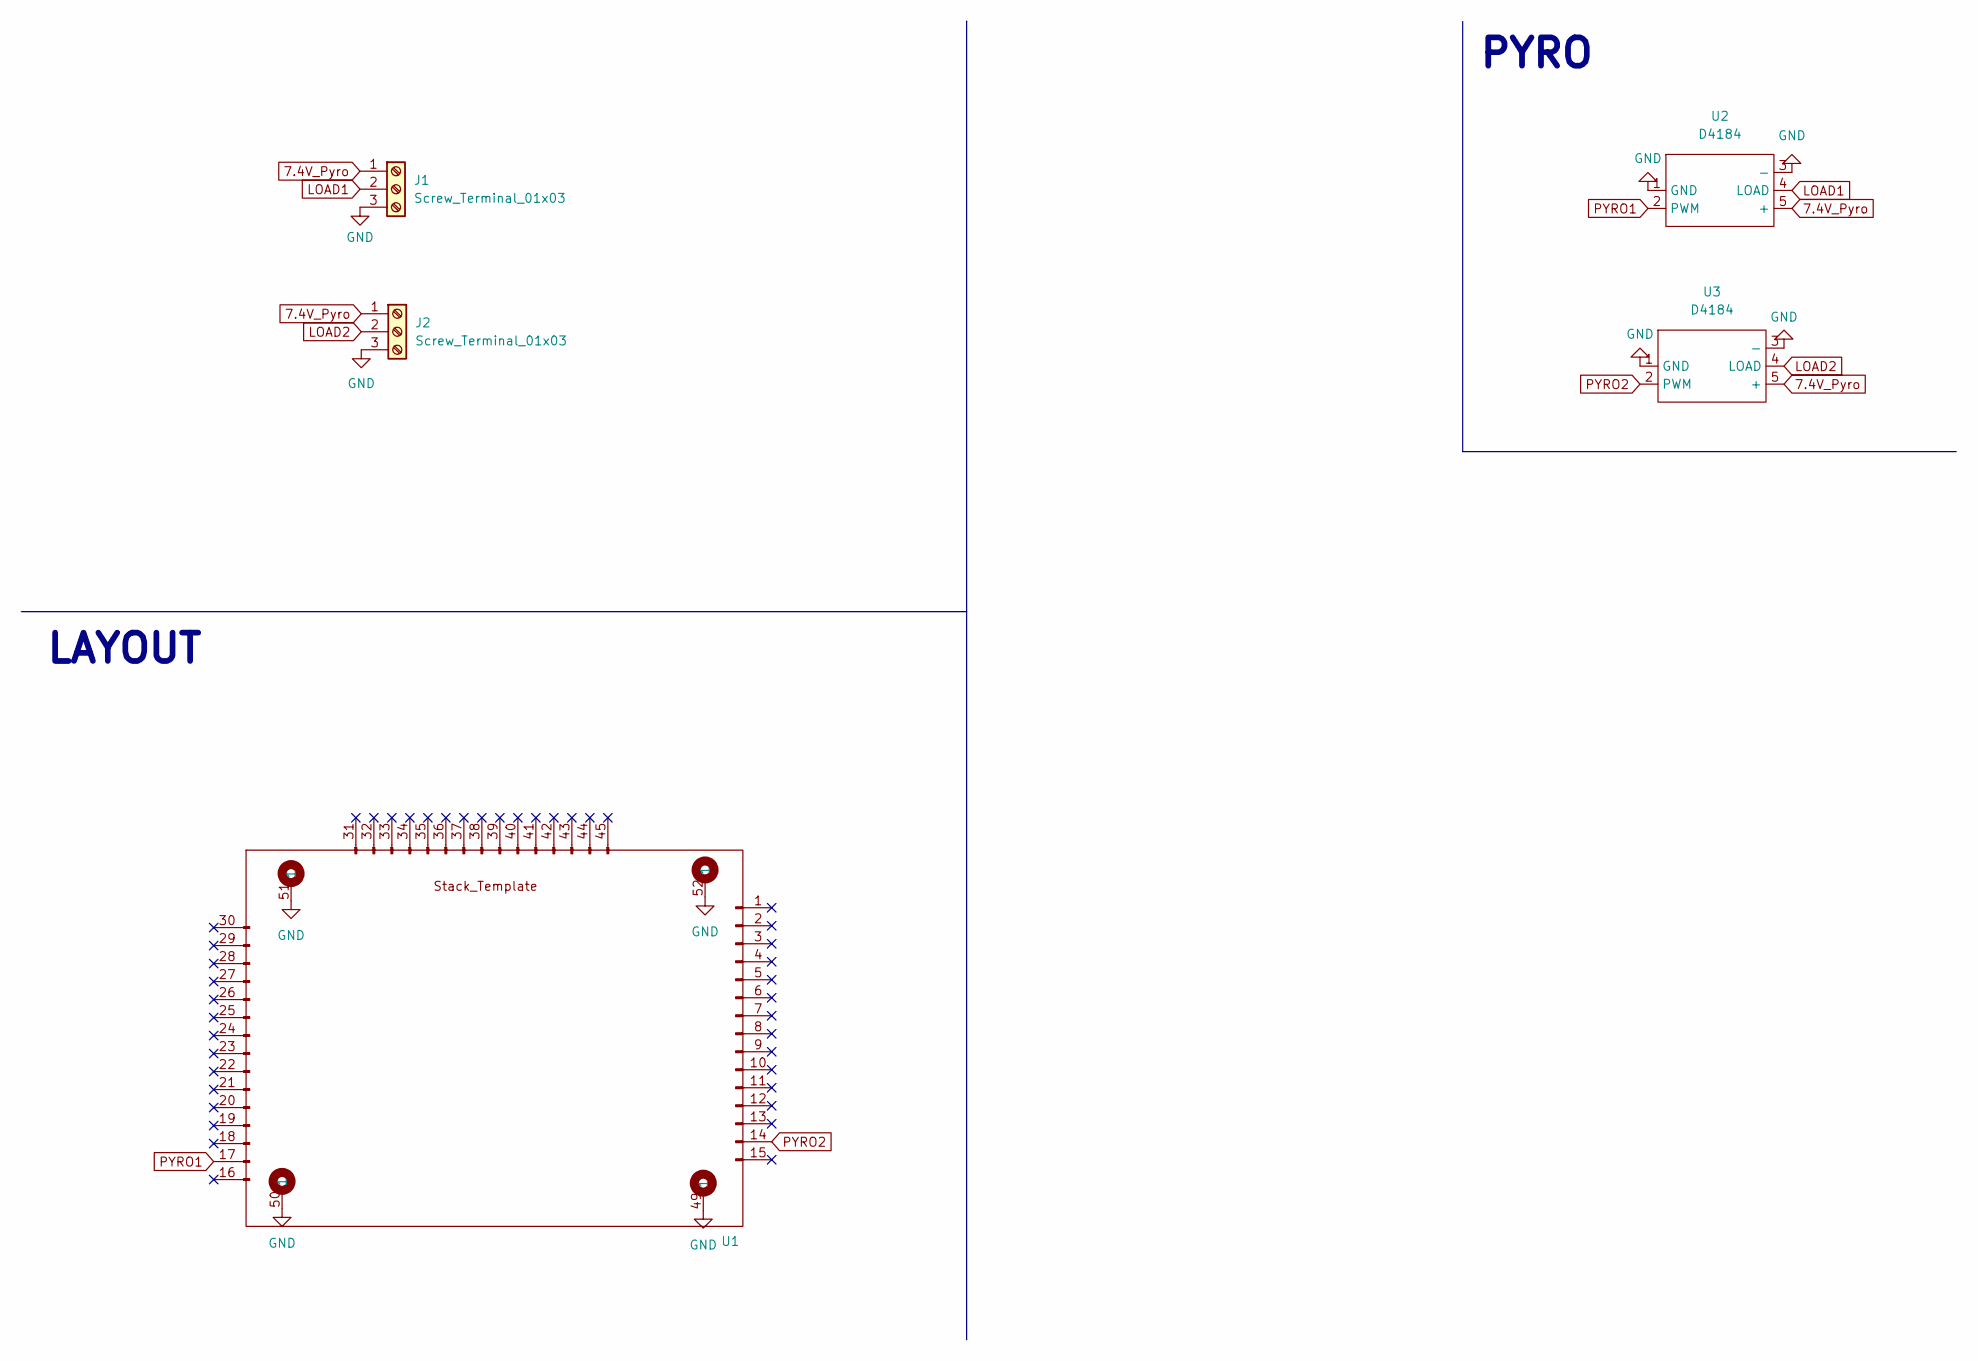
[picture p28: schematic GPIO_stack.kicad_sch]

Parts:
J1, J2: Screw_Terminal_01x03; TerminalBlock_bornier-3_P5.08mm
U1: FC_Stack_template
U2, U3: D4184

Connections:
7.4V_Pyro: J1.1, J2.1, U2.5 (+), U3.5 (+)
GND: J1.3, J2.3, U1.49 (1), U1.50 (1), U1.51 (1), U1.52 (1), U2.1 (GND), U2.3 (-), U3.1 (GND), U3.3 (-)
LOAD1: J1.2, U2.4 (LOAD)
LOAD2: J2.2, U3.4 (LOAD)
PYRO1: U1.17, U2.2 (PWM)
PYRO2: U1.14, U3.2 (PWM)

Notes on the sheet:
LAYOUT
PYRO

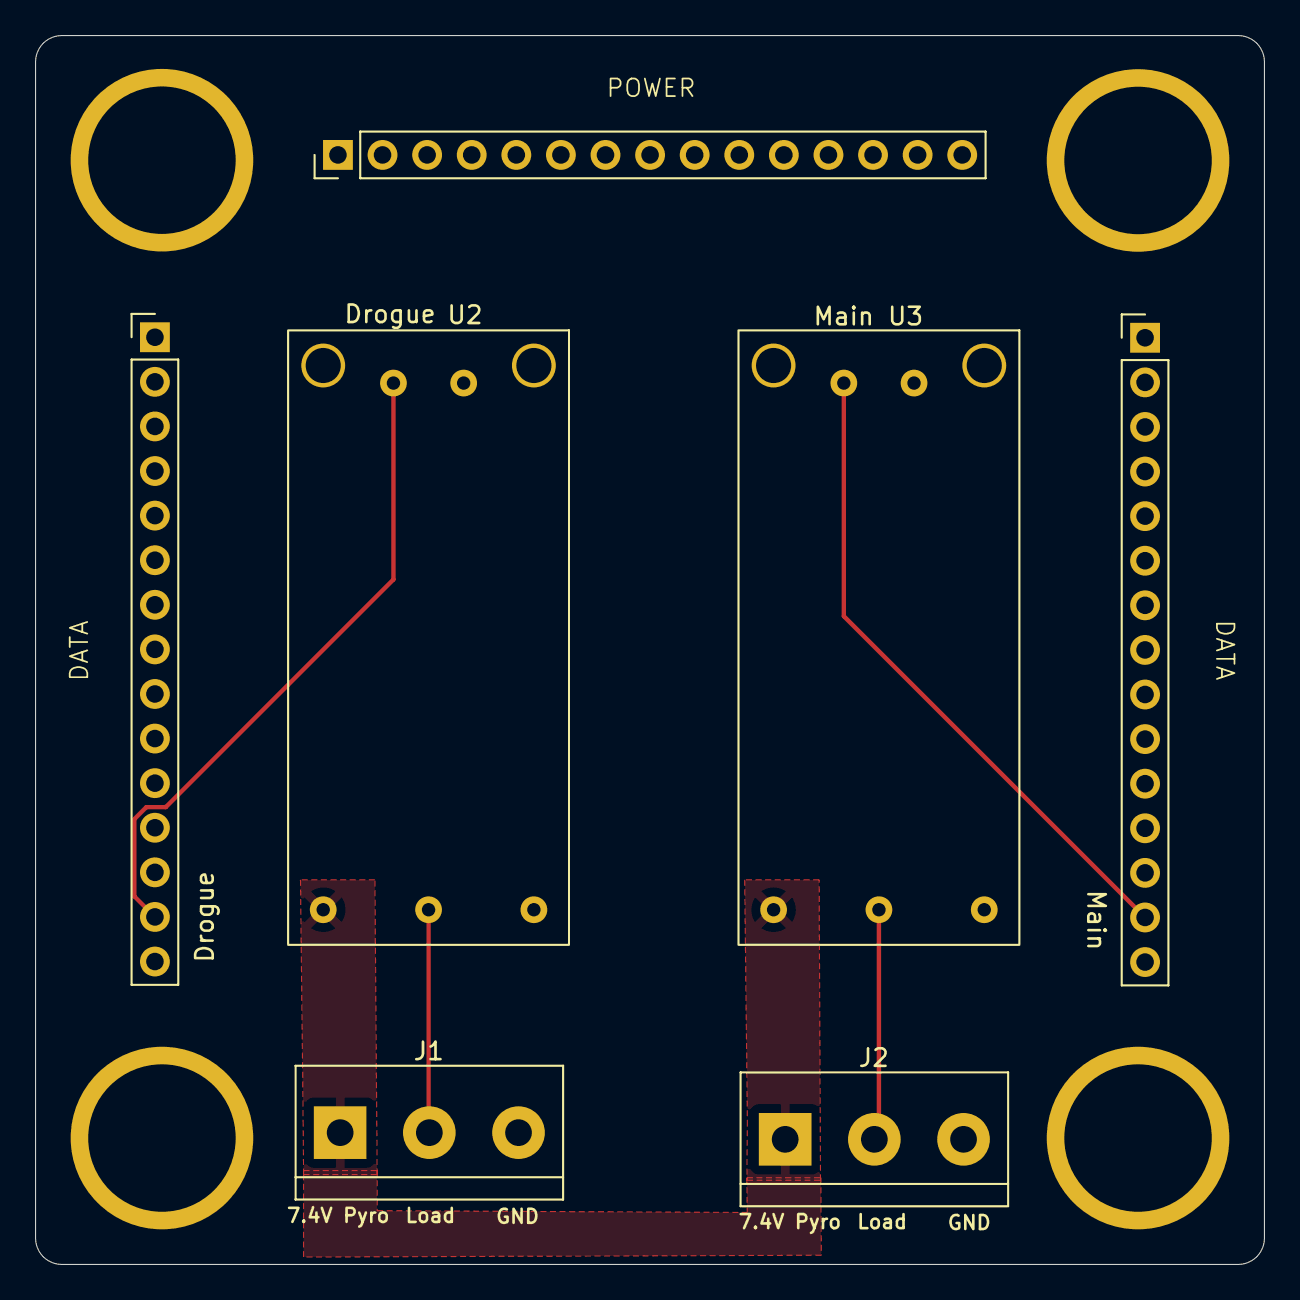
[picture p29: board GPIO_stack.kicad_pcb from above]

Board: 2 copper layers, 70.0 x 70.0 mm, 5 parts (0 on the bottom side), 6 nets.
